AMSAT-EA/easat-2/control termal/IMG_7941.JPG

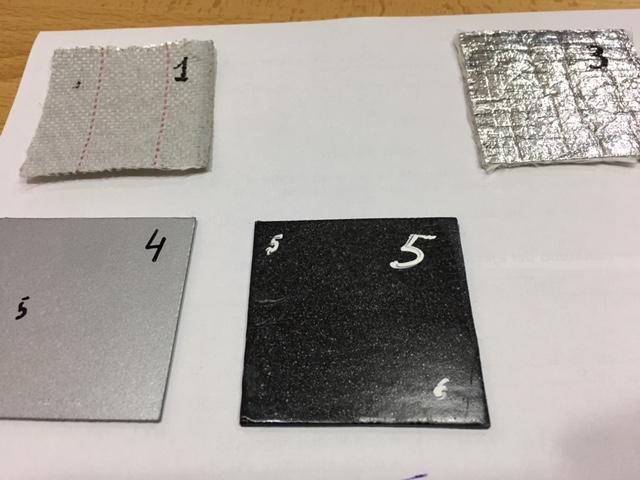
control termal/IMG_7941.JPG
