AMSAT-EA/easat-2/control termal/IMG_8060.JPG

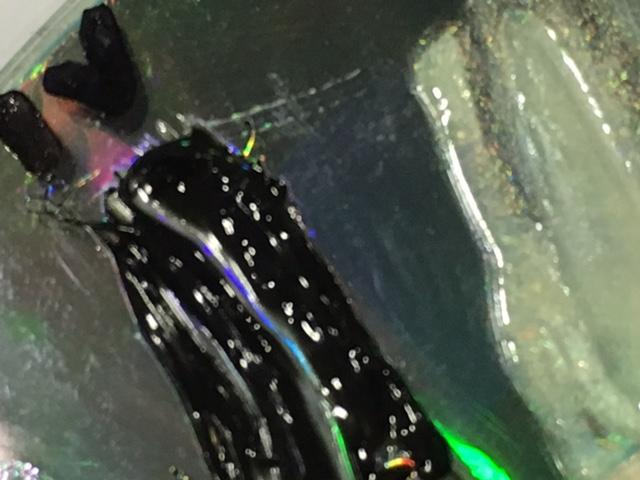
control termal/IMG_8060.JPG
