AMSAT-EA/easat-2/README.md

# easat-2
EASAT-2 satellite

This is the AMSAT EA Github repository for EASAT2 satellite project.

This is mainly an open hardware and software project and it is open to students.
The goal is designing and building a small FM repeater satellite, with CW beacon, in a pocketQube structure.

For more information visit our website at:

https://www.amsat-ea.org/easat2/

Este es el repositorio GitHub del proyecto de satélite EASAT2 de AMSAT EA.
Es un proyecto abierto de hardware y software.
El objetivo es diseñar y construir un pequeño satélite repetidor de FM, con una baliza morse, en una estructura del tipo pocketQube.

Para más información visita nuestra web en:

https://www.amsat-ea.org/easat2/
