AMSAT-EA/easat-2/control termal/Mat_1.pdf

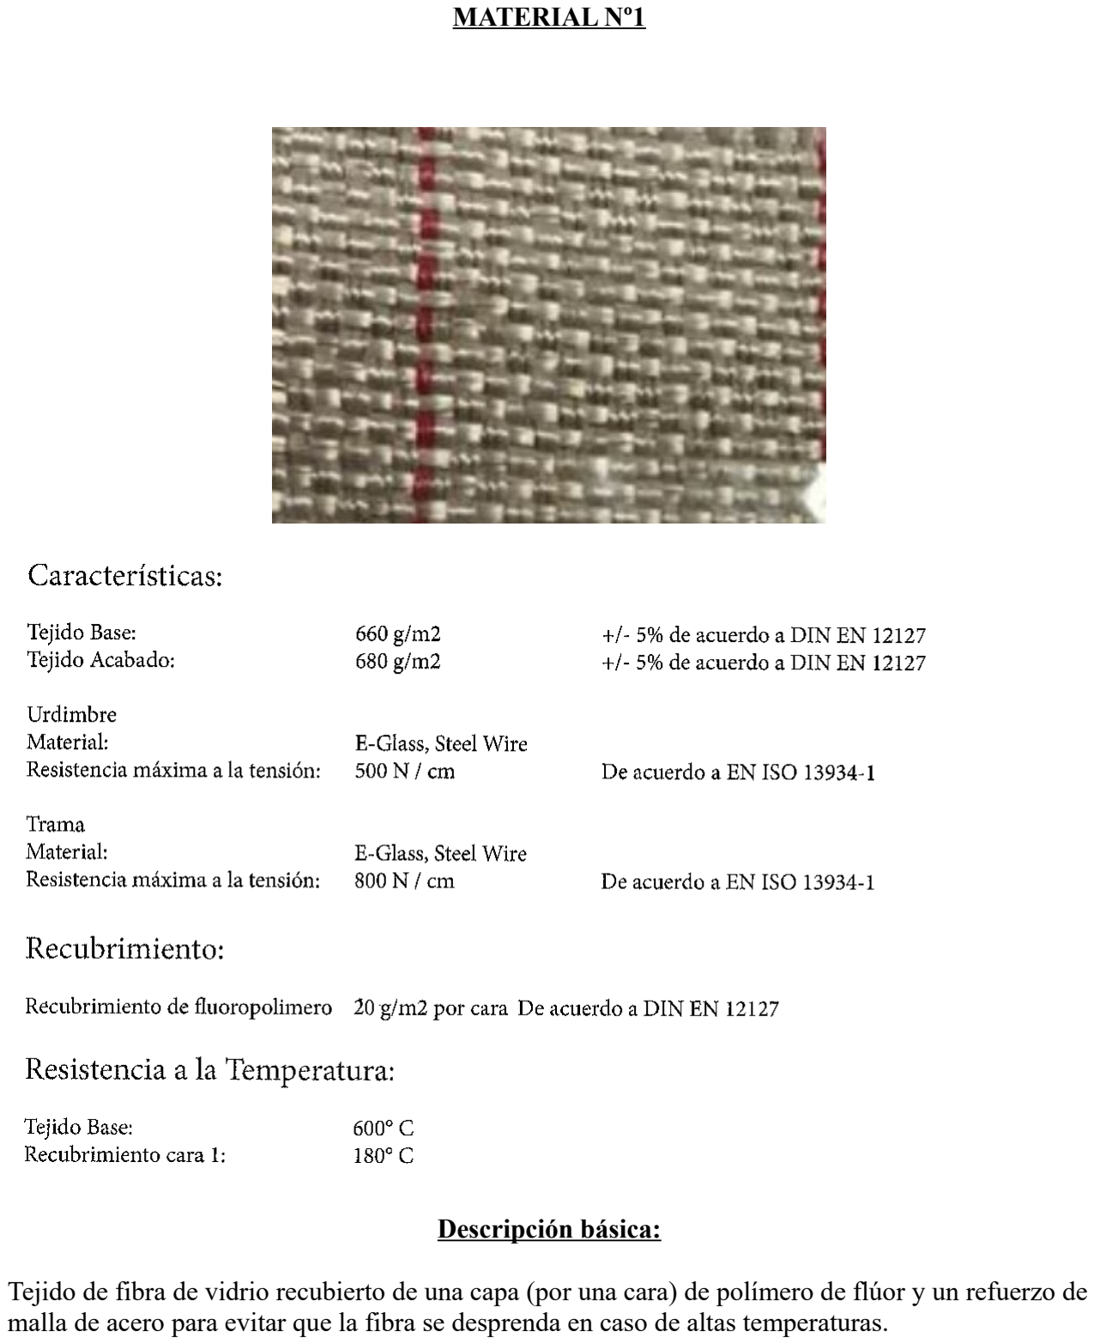
[picture p39: page 1]

MATERIAL Nº1

Descripción básica:

Tejido de fibra de vidrio recubierto de una capa (por una cara) de polímero de flúor y un refuerzo de malla de acero para evitar que la fibra se desprenda en caso de altas temperaturas.
