AMSAT-EA/easat-2/control termal/Mat_2.pdf

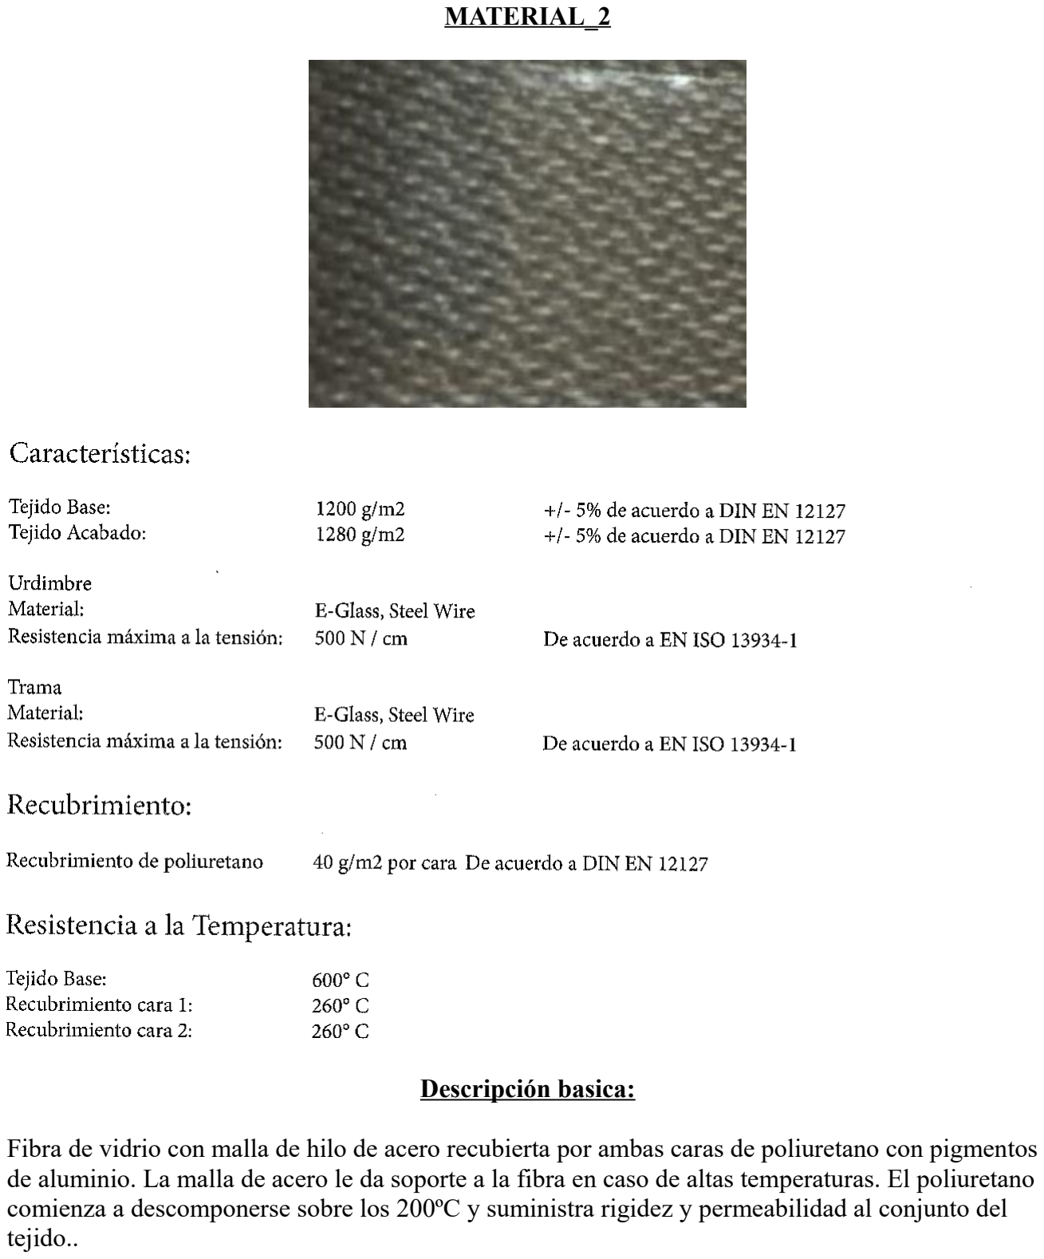
[picture p40: page 1]

MATERIAL_2

Descripción basica:

Fibra de vidrio con malla de hilo de acero recubierta por ambas caras de poliuretano con pigmentos de aluminio. La malla de acero le da soporte a la fibra en caso de altas temperaturas. El poliuretano comienza a descomponerse sobre los 200ºC y suministra rigidez y permeabilidad al conjunto del tejido..
