AMSAT-EA/easat-2/control termal/Mat_3.pdf

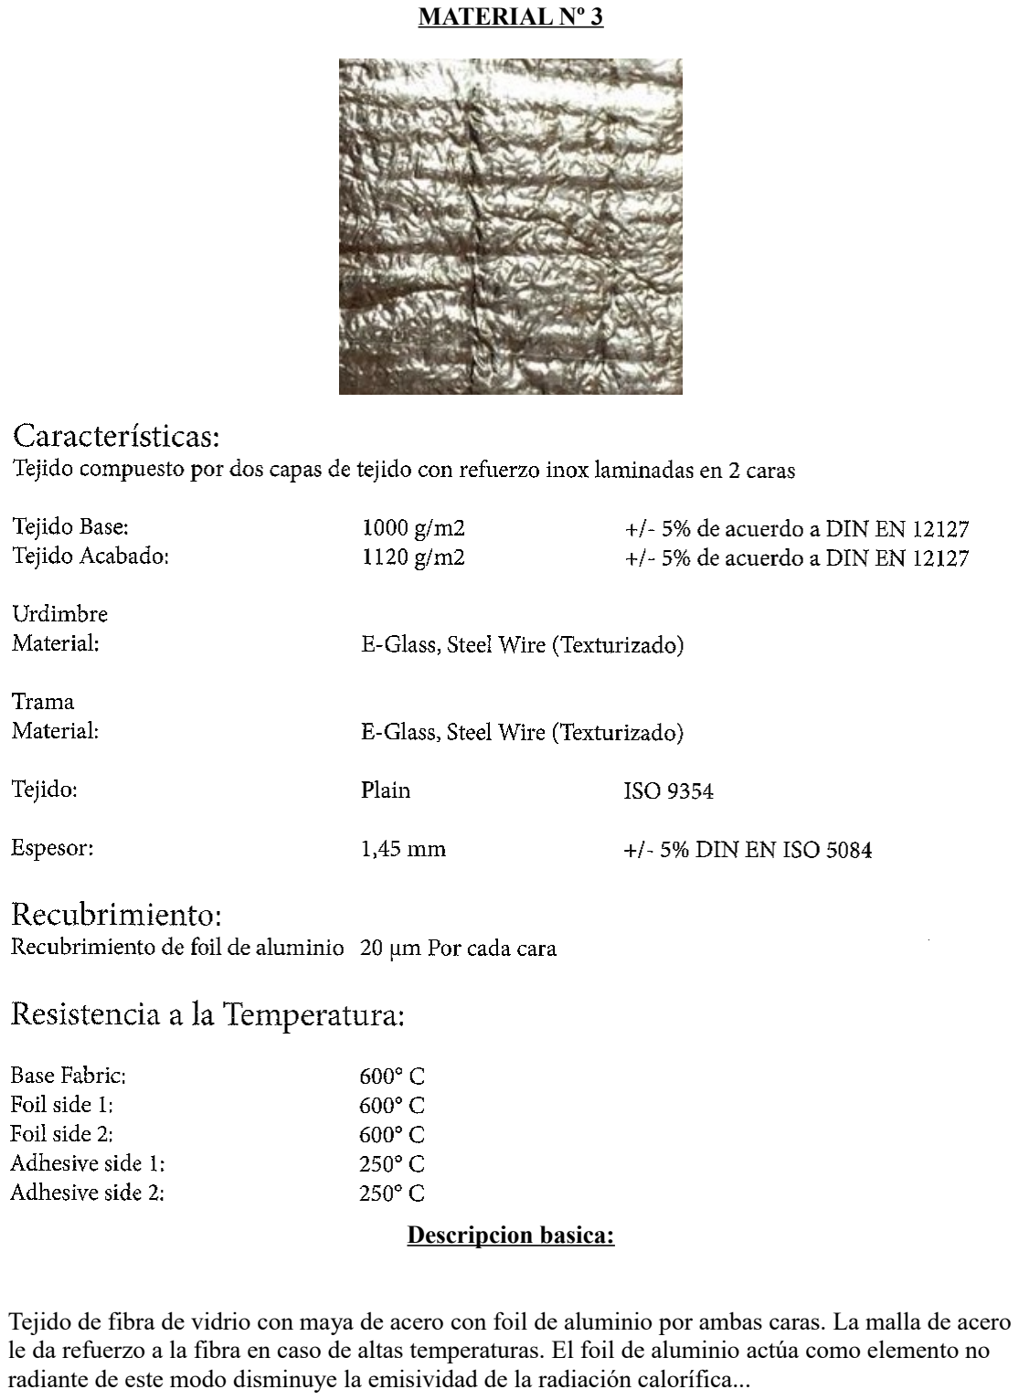
[picture p41: page 1]

MATERIAL Nº 3

Descripcion basica:

Tejido de fibra de vidrio con maya de acero con foil de aluminio por ambas caras. La malla de acero le da refuerzo a la fibra en caso de altas temperaturas. El foil de aluminio actúa como elemento no radiante de este modo disminuye la emisividad de la radiación calorífica...
