AMSAT-EA/easat-2/control termal/Ensayos_Mat_1.pdf

ENSAYOS TERMICOS PARA EASAT-2 CON MLI

Estimados compañeros como ya sabéis que viene siendo habitual en mi, adjunto os presento nuevos ensayos que he estado haciendo con los materiales MLI de que dispongo y que en anteriores entregas he ido exponiendo en la web del proyecto en la sección térmica..

En este caso he querido poner a prueba las mallas a llama directa para ver como se comporta la estructura y ver la capacidad del material una vez alcanzada una temperatura elevada.

Las pruebas esta vez están hechas en ambiente normal no como las anteriores que las hice en campana de vacío, lo cual lógicamente lleva a la transmisión de calor en condiciones de conducción cosa que no ocurre en el vacío. Pero creo que es interesante observar como se comportan estos materiales en condiciones adversas y como puede afectar a la estructura del sat...

El primer material numerado con el 1
es una MLI que esta expuesta en los archivos del proyecto y fundamentalmente es una urdimbre de hilo de acero sobre fibra de vidrio con una silicona resistente a la temperatura.

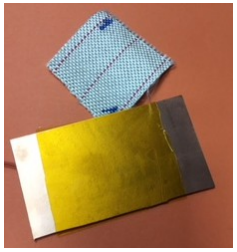
[picture p74: figure]

Fig.1 material nº1 y placa PCB con Kapton

El material lo he testeado sobre una placa de PCB de una cara en fibra de vidrio..

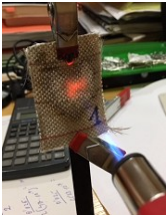
[picture p75: figure]
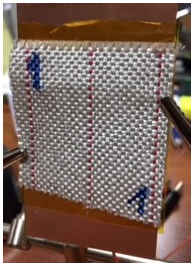
[picture p76: figure]

Fig.2 Foco de llama sobre Mat_1 | Fig.3 Colocación Mat_1 sobre soporte test

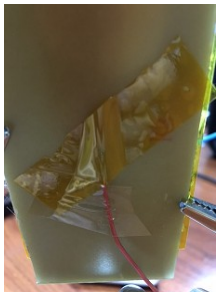
[picture p77: figure]

Fig. 4 Sonda termopar tras PCB

Al aplicar la llama al material tal y como se aprecia en las imágenes, puede verse como al cabo de unos segundos comienza a elevar su temperatura y acercarse poco a poco al rojo incandescente..

Las pruebas las he echo en 00:01:04 seg tal y como podéis ver en los datos reflejados al final.

La llama directa como podéis apreciar en los fotogramas térmicos ha alcanzado hasta 220 ºC y en la parte trasera del PCB donde tenia el termopar alcanzo según muestro en los datos y las gráficas 138,1 ºC..

Tras el tiempo de aplicación de la llama, (registre también durante unos cuantos segundos mas la curva de descenso de la temperatura, lo cual podéis ver en los datos..) se pueden apreciar los efectos que ha tenido sobre el material y la PCB....

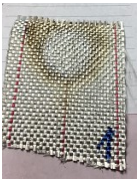
[picture p78: figure]
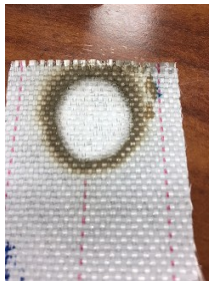
[picture p79: figure]
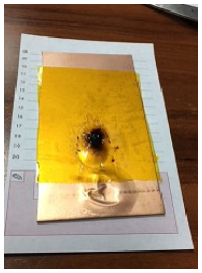
[picture p80: figure]

Fig. 5 cara frontal Mat_1 Fig. 6 cara trasera Mat_1 Fig. 7 cara frontal PCB tras el MLI

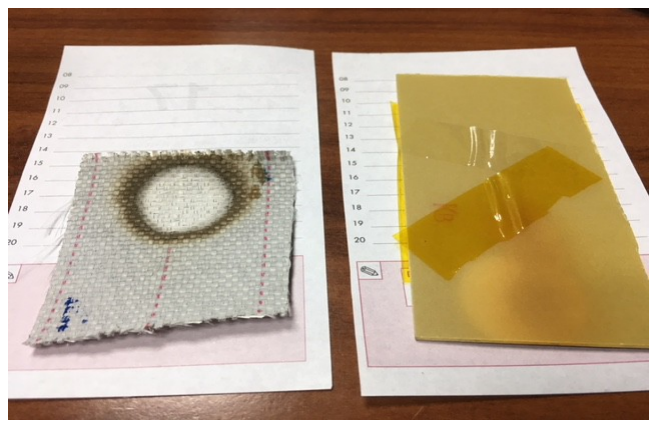
[picture p81: figure]

Fig.8 Mat_1 cara trasera y cara trasera PCB

Y este es el aspecto del material. Y en las siguientes fotos el material ampliado..

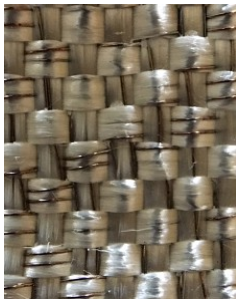
[picture p82: figure]
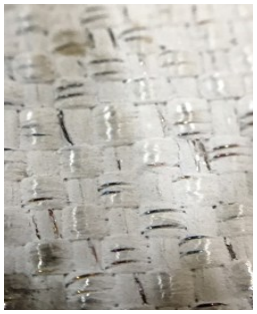
[picture p83: figure]

Fig. 9 Detalle urdimbre y fibra cara frontal Fig. 10 Detalle urdimbre y fibra cara posterior

Como podéis comprobar el material se comporta de un modo muy estable ante la temperatura elevada, y se dejan entrever la urdimbre de acero que le da resistencia y rigidez a la estructura.

El PCB por la cara en contacto con la MLI y el Kapton se ha llevado la peor parte y es una nota significativa la deformación de la capa de cobre debido seguramente al calentamiento del pegamento que se utiliza para adherir el cobre a la fibra, imagino que una vez en ebullición se ha evaporado y ha provocado la ampolla que se puede apreciar en la superficie un poco mas arriba del punto de calentamiento. Creo que este formato de estructura del Sat en PCB de 5x5 se ha descartado pero aun así he creído que este dato podía ser interesante.....

La parte trasera al contrario no presenta deformaciones en la fibra (un poco de decoloración) ni tampoco en la tira de Kapton que puse para sujetar el sensor.. “incluso un poco de film normal que puse para inmovilizar el cable del sensor tampoco de vio afectado.. “ :)

La termografia infrarroja nos sirve de referencia como indicador de la concentración y extensión del calor, en ambiente de conducción, radiación , etc.... En próximos ensayos realizare termografias en condiciones de vacío para ver la distribución de la temperatura sin el factor conducción....

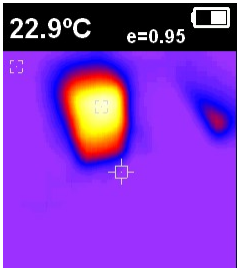
[picture p84: figure]
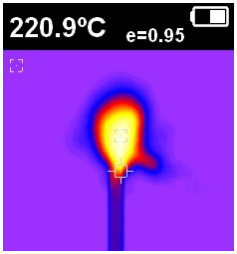
[picture p85: figure]

Fig: 11 Termografia infrarroja max tºC | Fig: 12 Termografia infrarroja en relajación

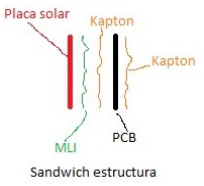
[picture p86: figure]

Fig. 14 Estructura propuesta

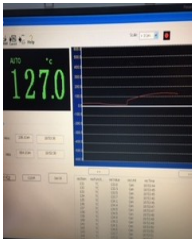
[picture p87: figure]

Fig. 13 Detalle max tºC en sonda

La idea inicial que expuse al principio de mis ensayos era la utilización de una especie de “sándwich” foto. 14 .
Si esto sirve de idea o ayuda para quien se encargue del aislamiento térmico del EASAT-2 creo que se podría realizar, bien enmarcando el conjunto con la estructura definitiva del sat o practicando unos agujeros en forma de ojales (estoy haciendo unas pruebas de cosido de urdimbre al rededor de la MLI y en los ojales) para que la MLI se pueda atornillar junto a las células solares...

Otro punto interesante de esta MLI es el ensayo de impacto que según he podido averiguar es de 30+/- 0,6 Kg con un empuje de hasta 180 J . Esto seria un punto también muy interesante ante fenómenos imprevistos de polvo o pequeñas partículas espaciales que pudieran impactar con el sat....

Próximamente subiré mas pruebas del resto de materiales para ver como se comportan.

TABLA DATOS DE SONDA:

recItem recFunction recValue recUnit recTime
1 | TC | 064.1 | Cen | 18:52:30
2 | TC | 065.5 | Cen | 18:52:30
3 | TC | 066.9 | Cen | 18:52:31
4 | TC | 067.6 | Cen | 18:52:31
5 | TC | 069.1 | Cen | 18:52:32
6 | TC | 070.5 | Cen | 18:52:33
7 | TC | 071.7 | Cen | 18:52:33
8 | TC | 072.4 | Cen | 18:52:34
9 | TC | 073.6 | Cen | 18:52:34
10 | TC | 074.8 | Cen | 18:52:35
11 | TC | 075.9 | Cen | 18:52:35
12 | TC | 076.5 | Cen | 18:52:36
13 | TC | 077.6 | Cen | 18:52:37
14 | TC | 078.7 | Cen | 18:52:37
15 | TC | 079.9 | Cen | 18:52:38
16 | TC | 080.5 | Cen | 18:52:38
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
151 | TC | 130.8 | Cen | 18:53:55
152 | TC | 130.2 | Cen | 18:53:55

153 | TC | 129.6 | Cen | 18:53:56
154 | TC | 129.0 | Cen | 18:53:57
155 | TC | 128.6 | Cen | 18:53:57
156 | TC | 128.0 | Cen | 18:53:58
157 | TC | 127.3 | Cen | 18:53:58
158 | TC | 127.0 | Cen | 18:53:59
