AMSAT-EA/easat-2/presentaciones/AMSAT EA - IBERRADIO 2017 SATELITE-EASAT2-rev4.pdf

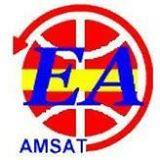
[picture p101: figure]

# SATÉLITE EASAT2

### Progreso y estado actual

# Equipo

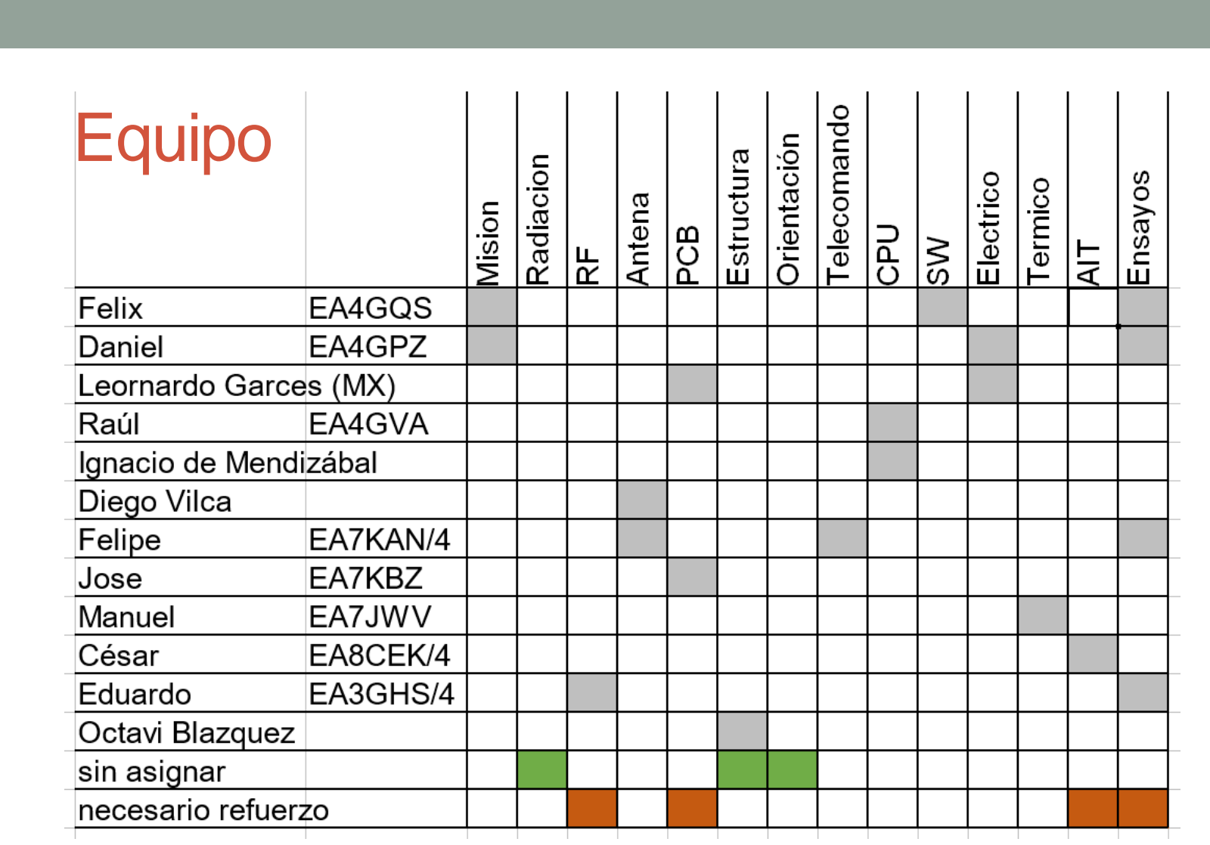
[picture p102: page 2]

# Misión

### - Satélite órbita baja para comunicaciones por voz - Modo principal de trabajo FM

- Pero posibilidad de otras modalidades (transpondedor lineal)

### - Subida en VHF y bajada en UHF - Operable con

- Walkie-talkies
- Antena directiva de mano

### - Arquitectura: PocketQube 5x5x10cm

# Organización

### - ¿Cuál es la lista de tareas a realizar para construir y lanzar un satélite al espacio? - Para ser exhaustivos y no olvidar nada, el plan se ha inspirado en los libros:

- Space mission engineering, The New SMAD, Larson-Wertz-Everett
- Spacecraft System Engineering Misión, Fortescue

# Tareas

### ÓRBITA Y TRANSPORTE

- Geometría orbital
- Deorbit
- Transporte
- Expulsor

### ENTORNO ESPACIAL

- Radiación
- Electroestática
- Selección Componentes

### CARGA UTIL

- Transponder VHF>UHF
- Antenas

### SUBSISTEMAS

- Estructura
- Orientación y control
- Telecomando/telemetría
- Unidad de control+Software
- Subsistema eléctrico EPS
- Control térmico

### AIT

- Modelos
- Fabricación+Ensamblaje
- Campaña de Ensayos

# Requisitos

### - Construir satélite para comunicaciones por voz - Modo principal: FM

- deseable otros modos (-> transpondedor lineal)

### - Subida en VHF y bajada en UHF - Operable con walkie-talkies y antena directiva de mano - Limitaciones

- Técnicas: algunos elementos deben adquirirse
- Estructura
- Paneles solares
- Económicas: mínimo coste posible
- PocketQube 5x5x10cm preferible a CubeSat
- Órbita LEO
- Componentes no específicos espacio/balance coste-riesgo

# Orbita, Transporte y Lanzador (POD)

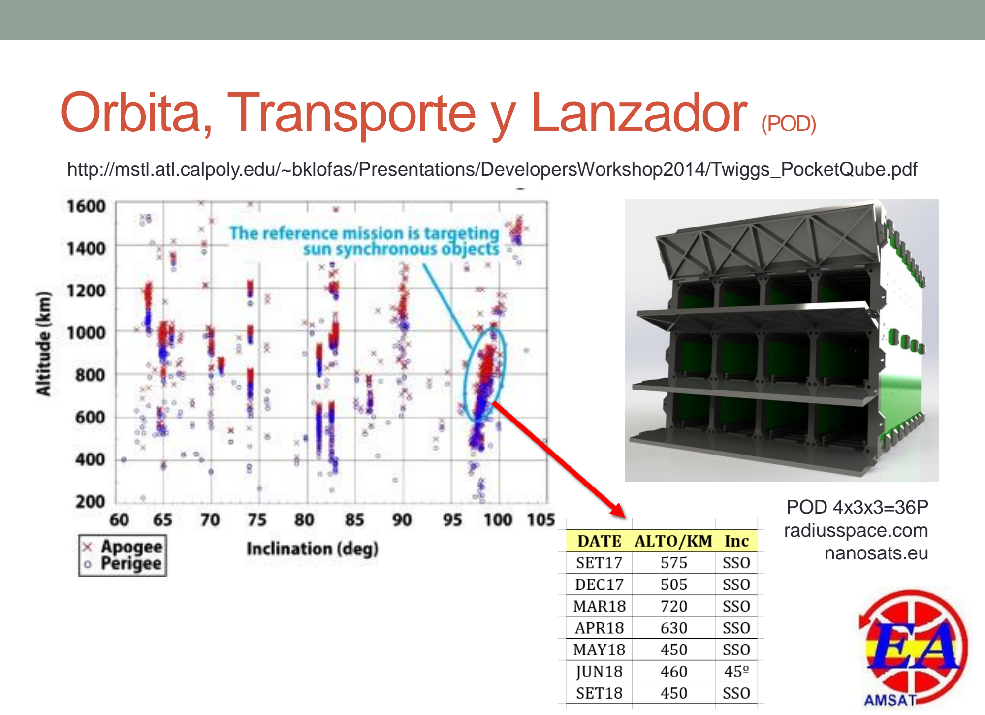
[picture p103: page 7]

http://mstl.atl.calpoly.edu/~bklofas/Presentations/DevelopersWorkshop2014/Twiggs_PocketQube.pdf

POD 4x3x3=36P
radiusspace.com
nanosats.eu

# Entorno Espacial

- Radiación
- Electroestática
- Selección Componentes

SIN ASIGNAR, SE BUSCA VOLUNTARIO

# Determinación de orientación y control

Eje Z:
- Un imán alinea el eje con el campo magnético de la tierra
- Sobre este eje se monta un dipolo RX/TX
Ejes X/Y:
- Giran libremente
- Estimado: 10grados/min
IDEAS:
- Uso de pinturas (?)
- Uso de los paneles solares para conocer la posición del sol (?)
- ….

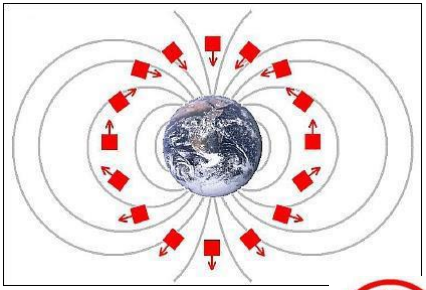
[picture p104: figure]

SIN ASIGNAR, SE BUSCA VOLUNTARIO

# Energía generada

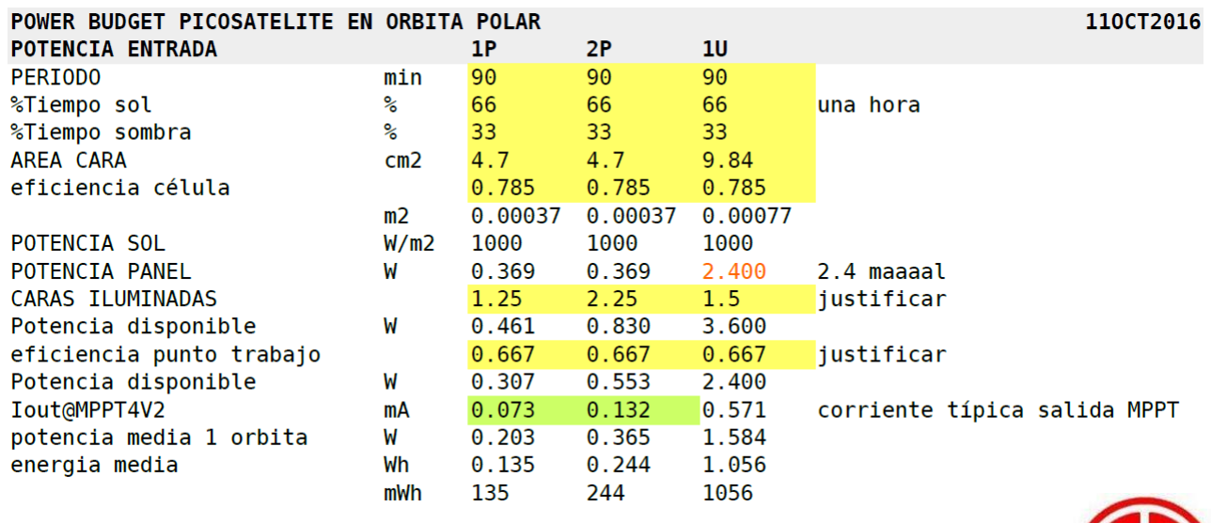
[picture p105: figure]

# Balance de Enlace

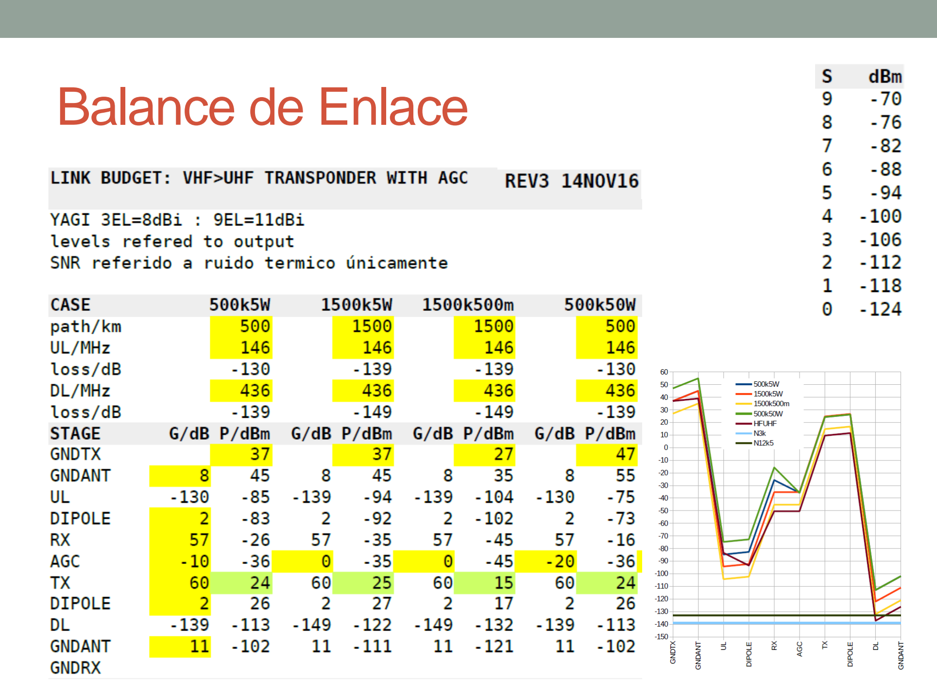
[picture p106: page 11]

# Partes del satélite

- Transponder VHF>UHF
- Antenas
- Estructura
- Orientación y control
- Telecomando/telemetría
- Unidad de control
- Software
- Subsistema eléctrico EPS
- Control térmico

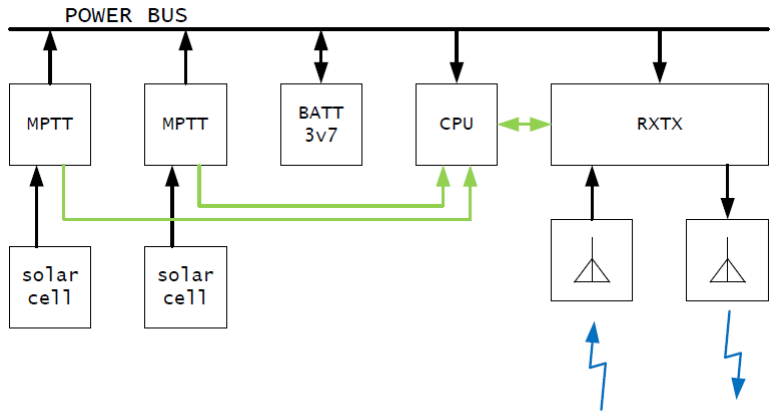
[picture p107: figure]
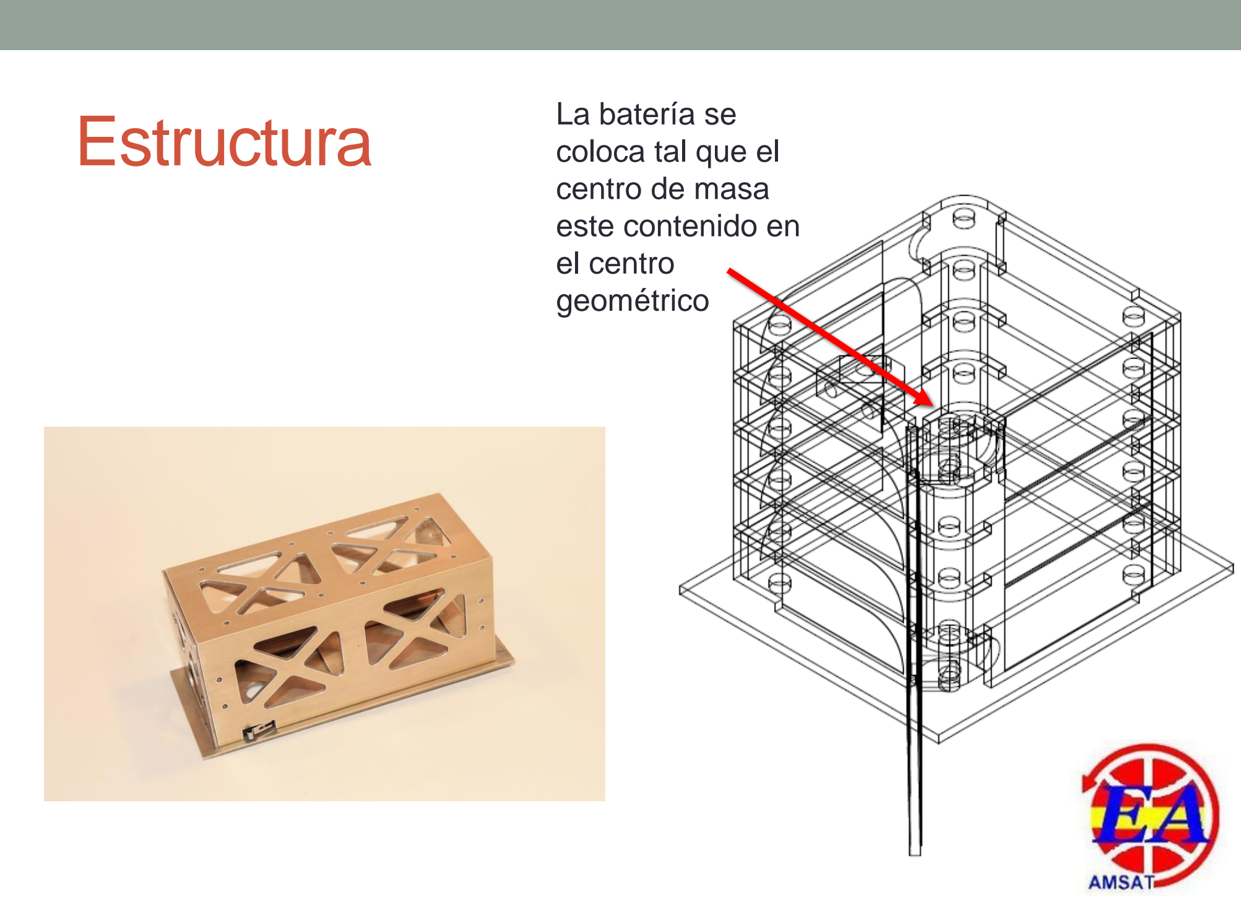
[picture p108: page 13]

Estructura | La batería se coloca tal que el centro de masa este contenido en el centro geométrico

# Unidad de Control CPU

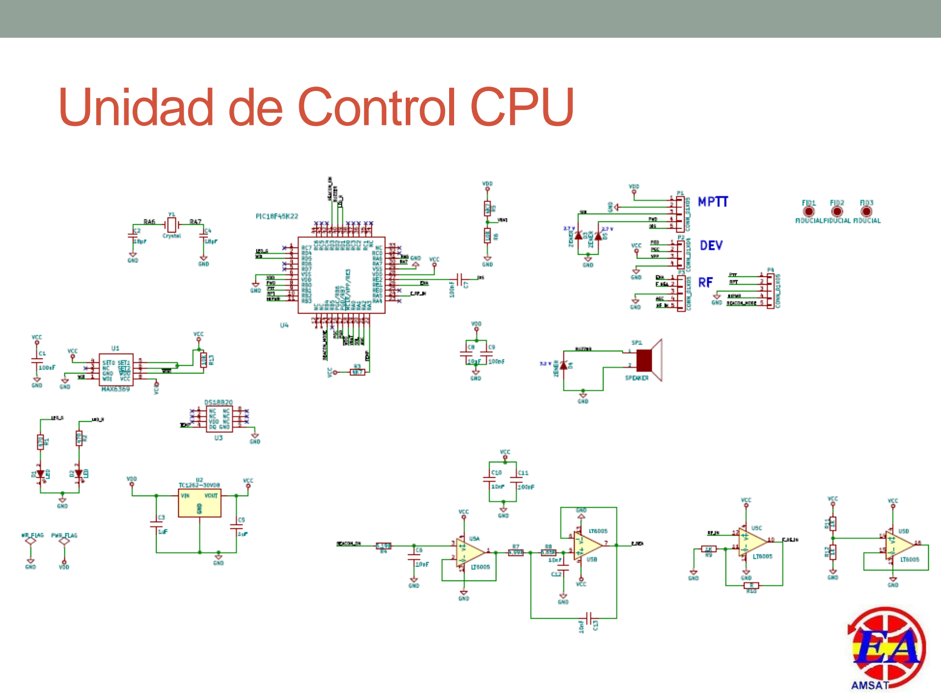
[picture p109: page 14]

# Unidad de Control CPU (dev)

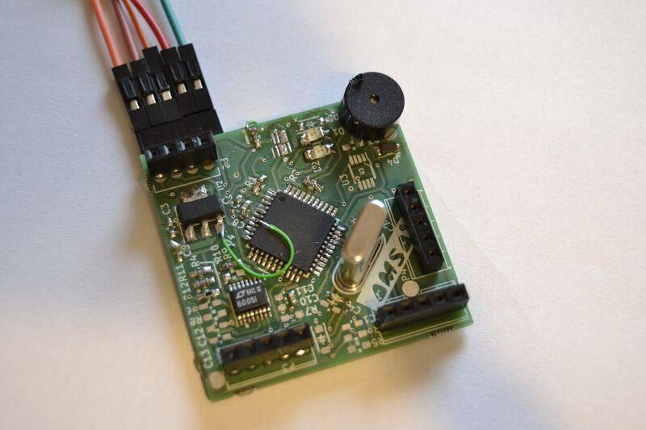
[picture p110: figure]

# Subsistema eléctrico

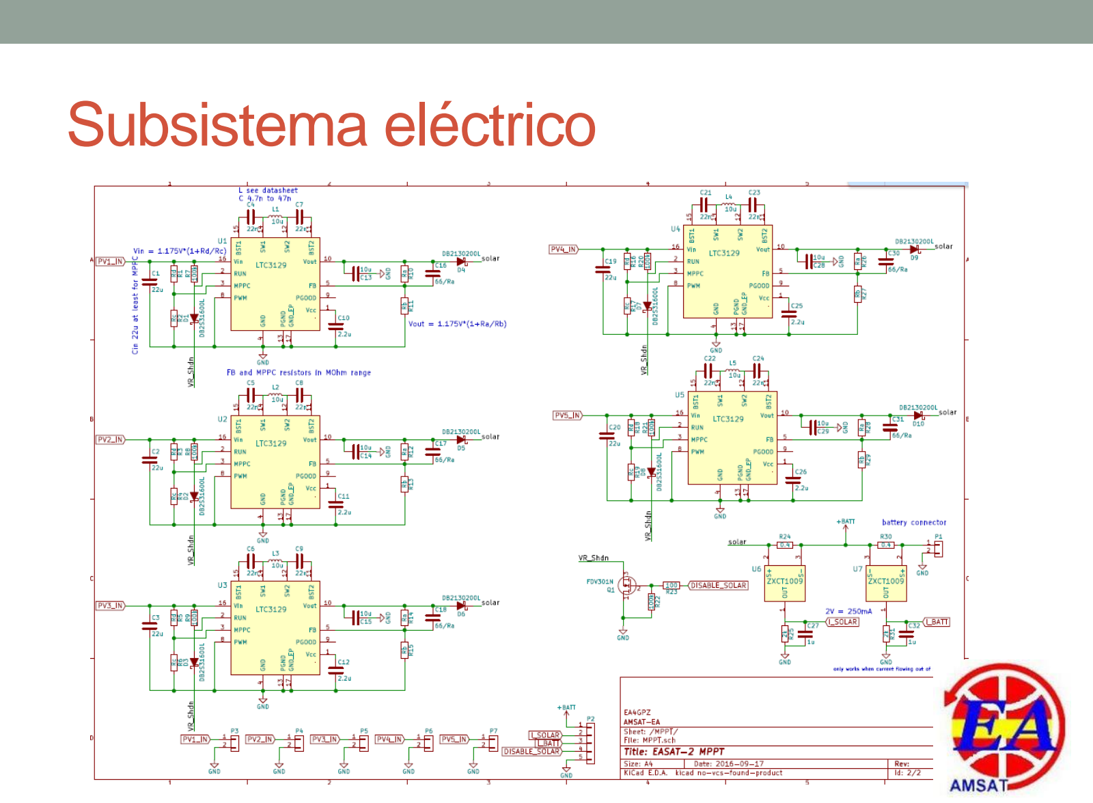
[picture p111: page 16]

# Transponder VHF>UHF

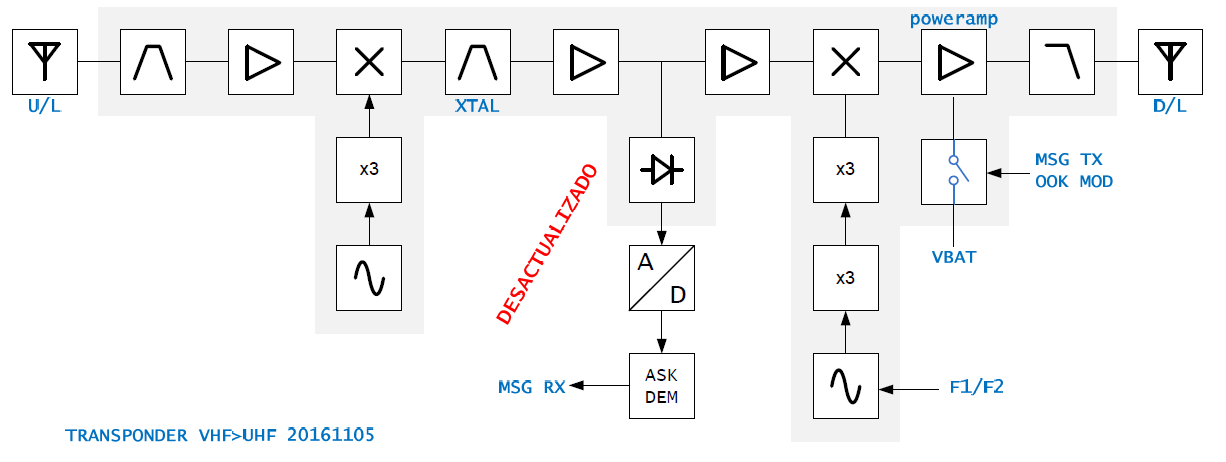
[picture p112: figure]

# Control térmico

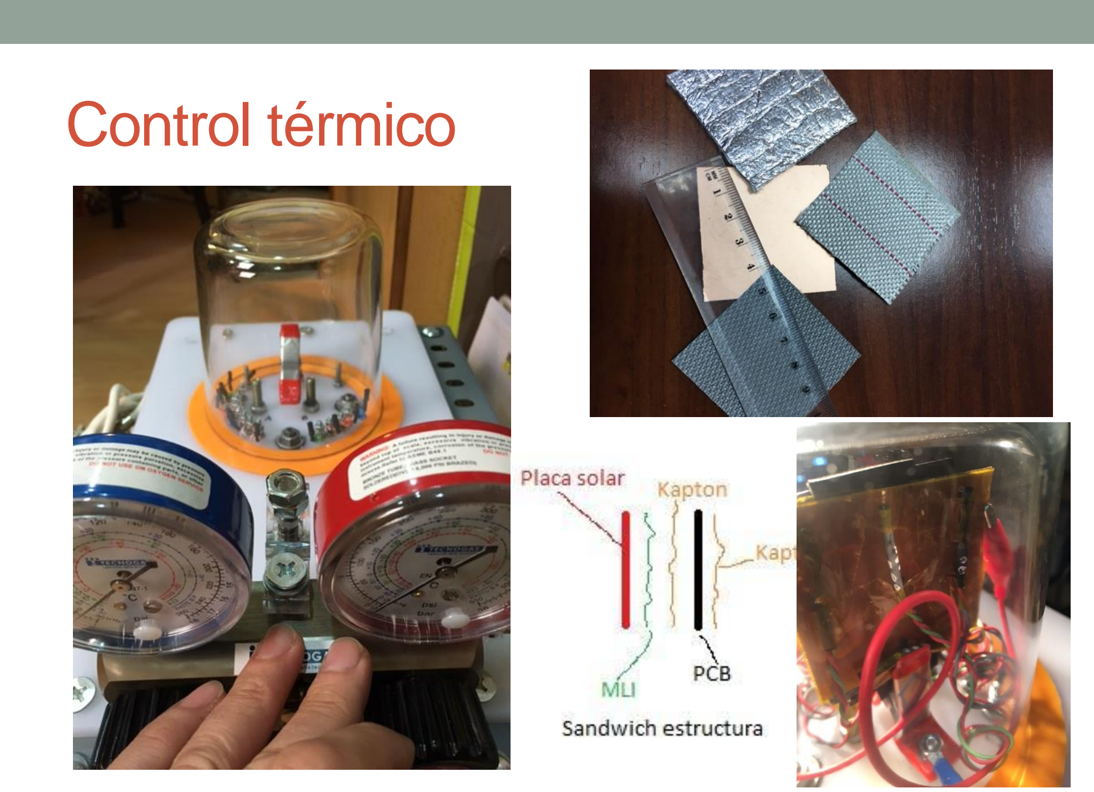
[picture p113: page 18]

# Filosofía de modelos

- Prototipo
- funcional (con placas RF comerciales)
- eléctrico BB (equivalente exacto eléctrico)
- Modelo
- de Vuelo FM
- de Calificación QM
- FM y QM idénticos
- El modelo FM
- se ensaya en un rango reducido de temperaturas y vibraciones para evitar estresarlo
- es el que finalmente vuela
- El modelo QM
- Se estresa durante los ensayos
- se queda en tierra y sirve como banco de ensayos a efectos comparativos
- vuela en la siguiente oportunidad, si el cohete explota

# ¿Te unes al reto?

contacto@amsat-ea.org

Sigue el desarrollo en:

https://www.amsat-ea.org/easat2https://github.com/AMSAT-EA/easat-2

# ¿Comentarios? ¿Preguntas?
