AMSAT-EA/easat-2/control termal/Foto_1.jpg

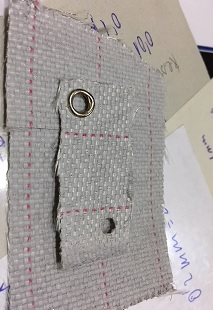
control termal/Foto_1.jpg
