AMSAT-EA/easat-2/control termal/Foto_2.jpg

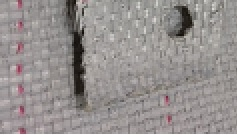
control termal/Foto_2.jpg
