AMSAT-EA/easat-2/control termal/image1 (1).JPG

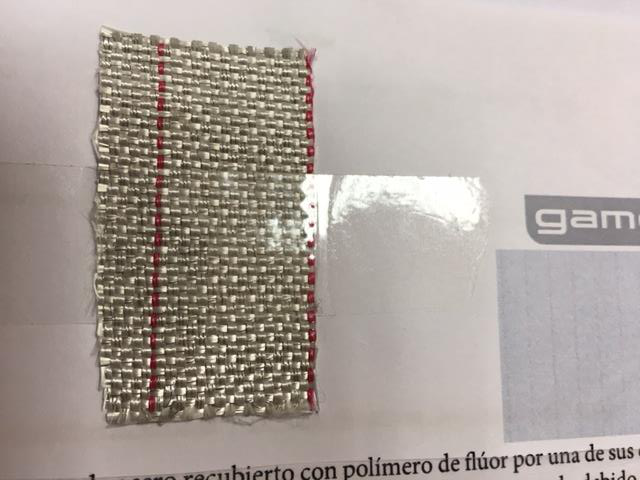
control termal/image1 (1).JPG
