AMSAT-EA/easat-2/control termal/image2.JPG

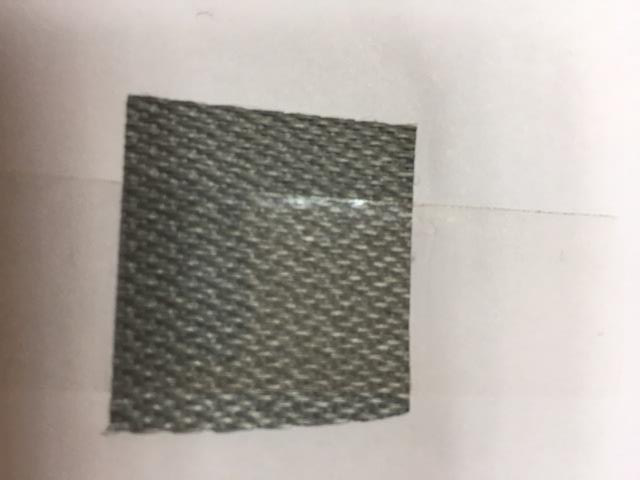
control termal/image2.JPG
