AMSAT-EA/easat-2/control termal/image3.JPG

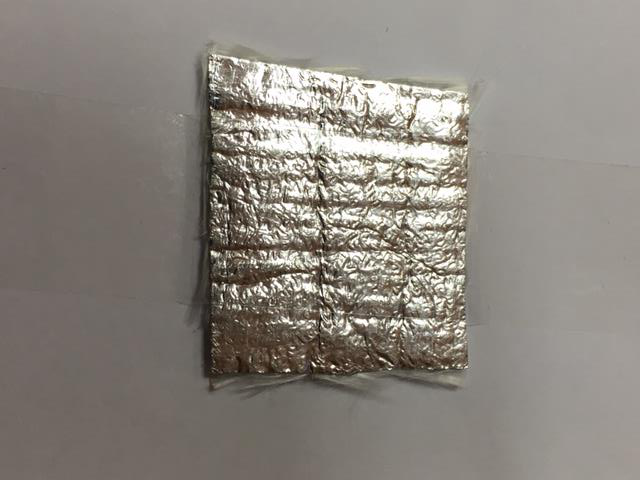
control termal/image3.JPG
