AMSAT-EA/easat-2/control termal/IMG_6163.JPG

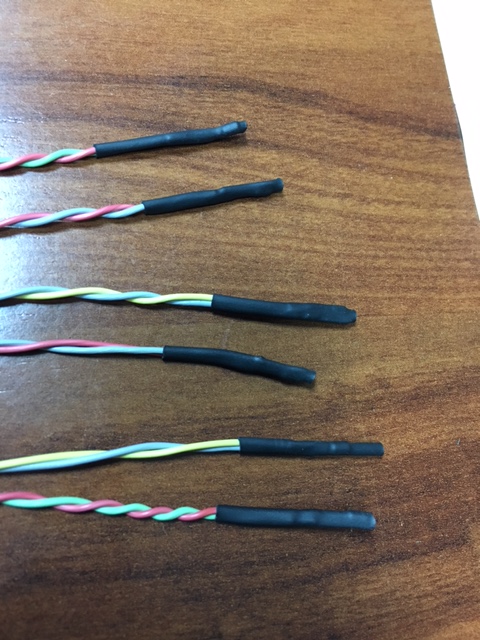
control termal/IMG_6163.JPG
