AMSAT-EA/easat-2/control termal/IMG_6236.JPG

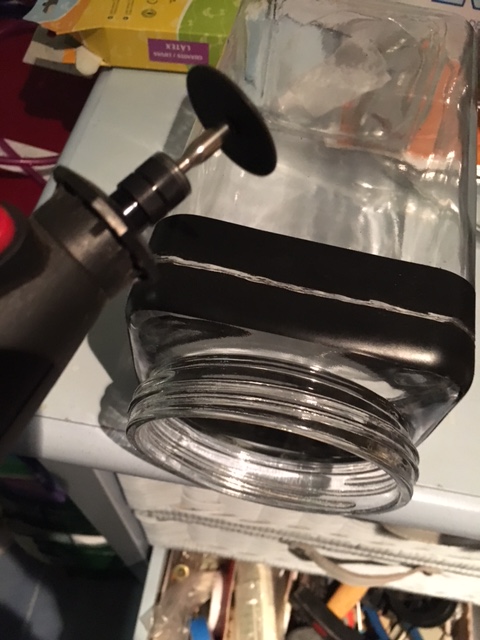
control termal/IMG_6236.JPG
