AMSAT-EA/easat-2/control termal/IMG_6239.JPG

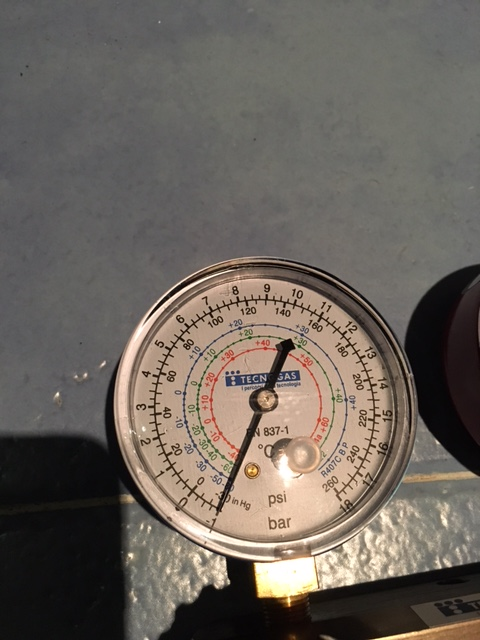
control termal/IMG_6239.JPG
