AMSAT-EA/easat-2/control termal/IMG_6240.JPG

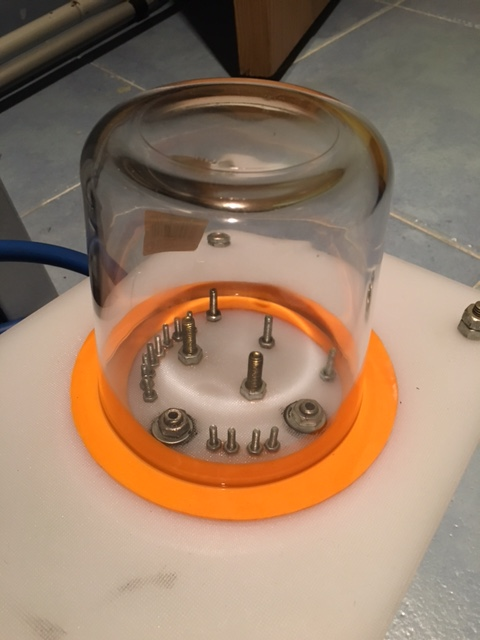
control termal/IMG_6240.JPG
