AMSAT-EA/easat-2/control termal/IMG_7440.JPG

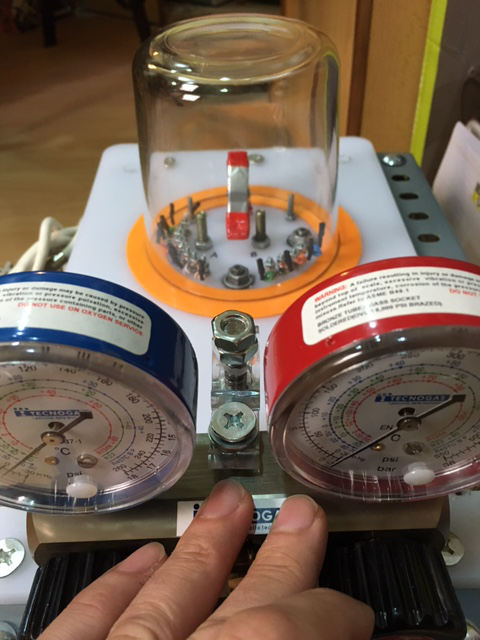
control termal/IMG_7440.JPG
