AMSAT-EA/easat-2/control termal/IMG_7460.JPG

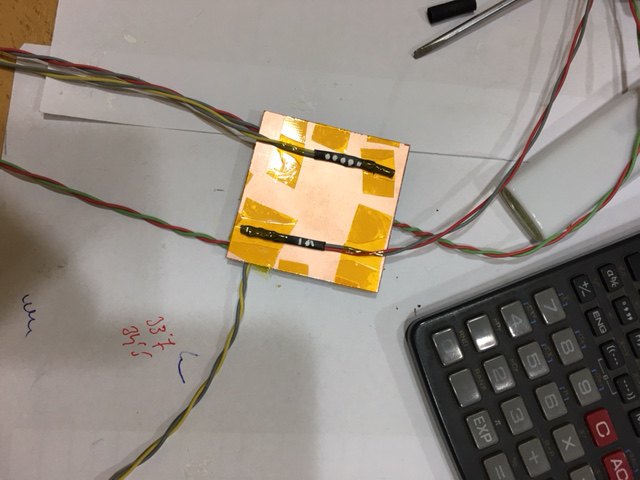
control termal/IMG_7460.JPG
