AMSAT-EA/easat-2/control termal/IMG_7461.JPG

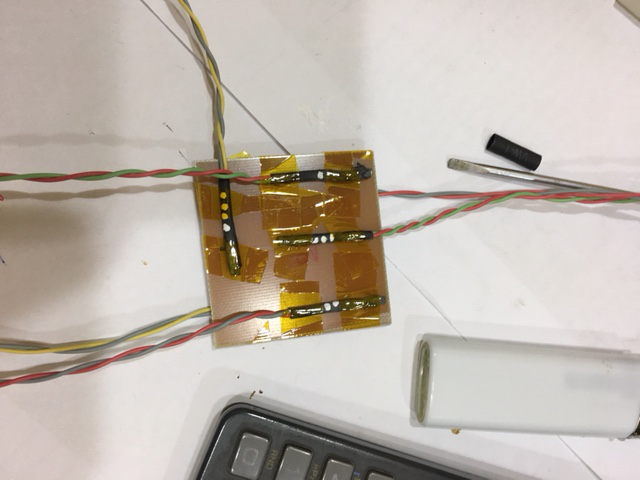
control termal/IMG_7461.JPG
