AMSAT-EA/easat-2/control termal/IMG_7466.JPG

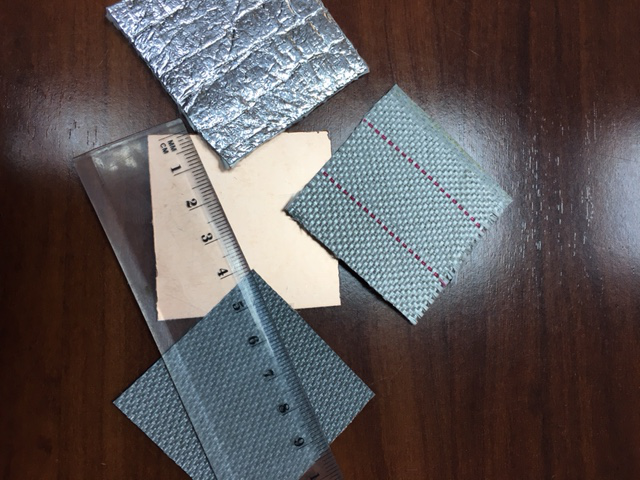
control termal/IMG_7466.JPG
