AMSAT-EA/easat-2/control termal/IMG_7469.JPG

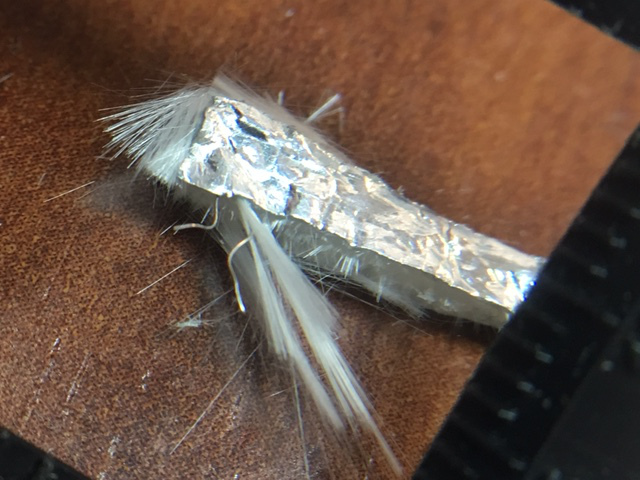
control termal/IMG_7469.JPG
