AMSAT-EA/easat-2/control termal/IMG_7470.JPG

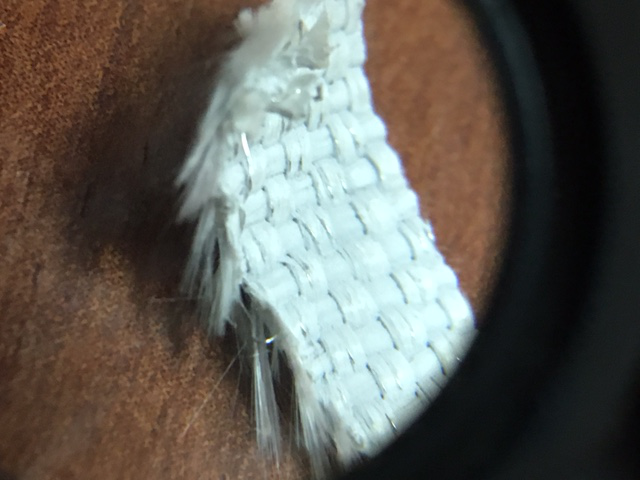
control termal/IMG_7470.JPG
