AMSAT-EA/easat-2/control termal/IMG_7478.JPG

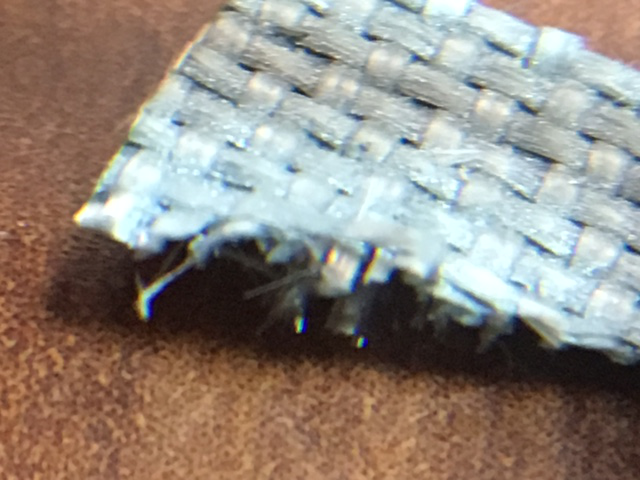
control termal/IMG_7478.JPG
