AMSAT-EA/easat-2/control termal/IMG_7540.JPG

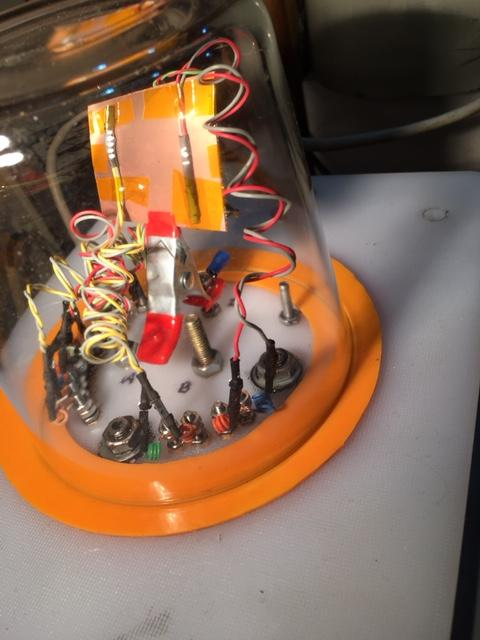
control termal/IMG_7540.JPG
