AMSAT-EA/easat-2/control termal/IMG_7542.JPG

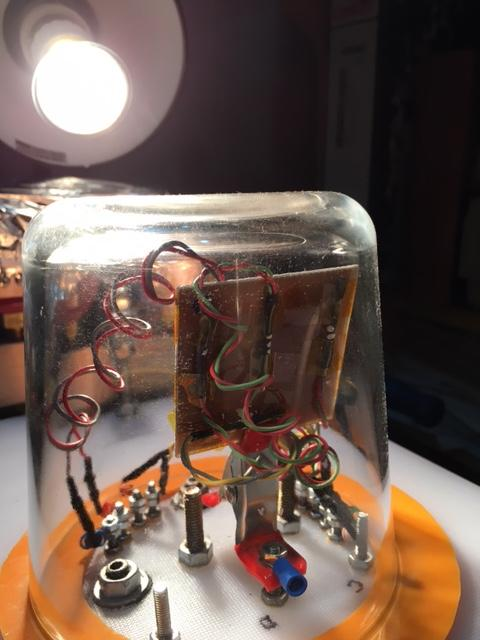
control termal/IMG_7542.JPG
