AMSAT-EA/easat-2/control termal/IMG_7548.JPG

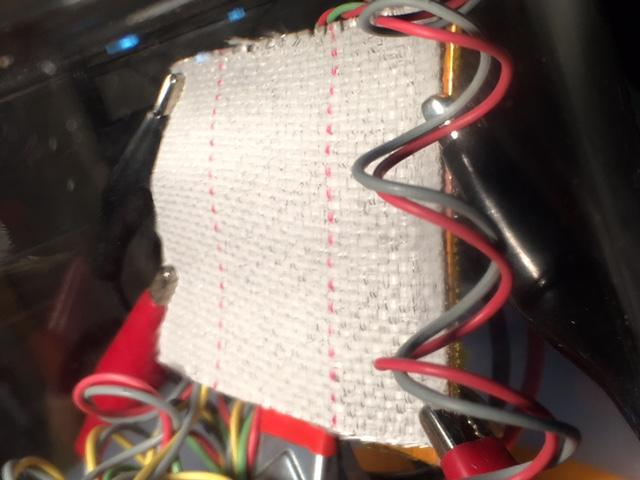
control termal/IMG_7548.JPG
