AMSAT-EA/easat-2/control termal/IMG_7549.JPG

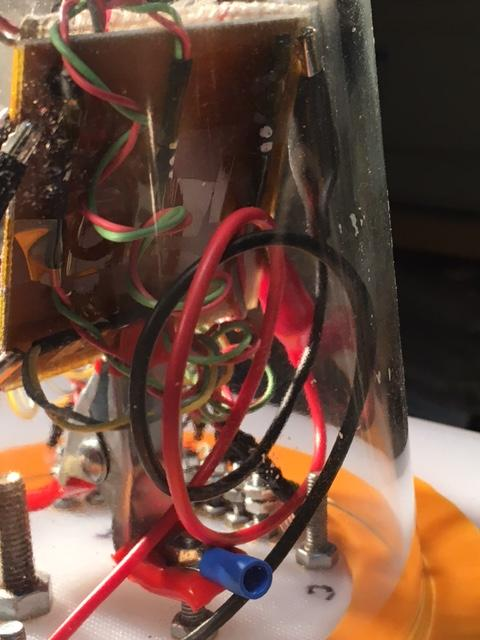
control termal/IMG_7549.JPG
