AMSAT-EA/easat-2/control termal/IMG_7943.JPG

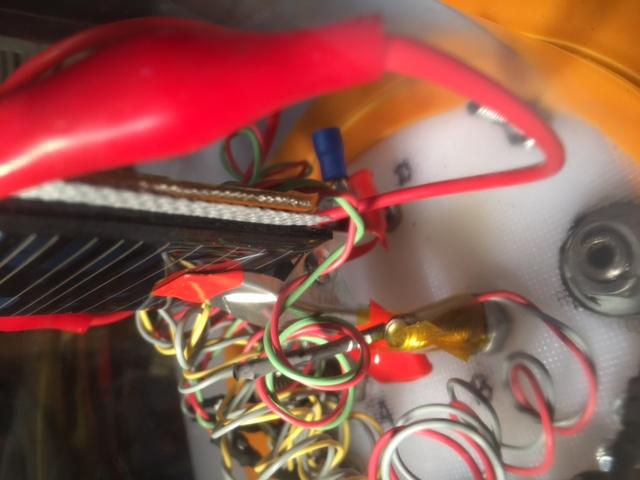
control termal/IMG_7943.JPG
