AMSAT-EA/easat-2/control termal/IMG_7944.JPG

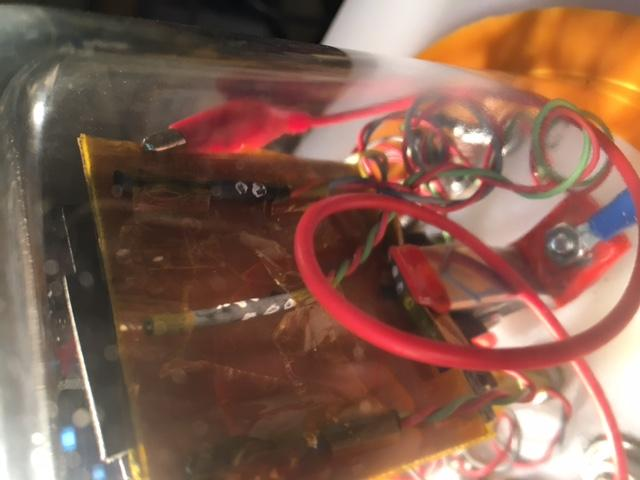
control termal/IMG_7944.JPG
