AMSAT-EA/easat-2/control termal/IMG_8010.JPG

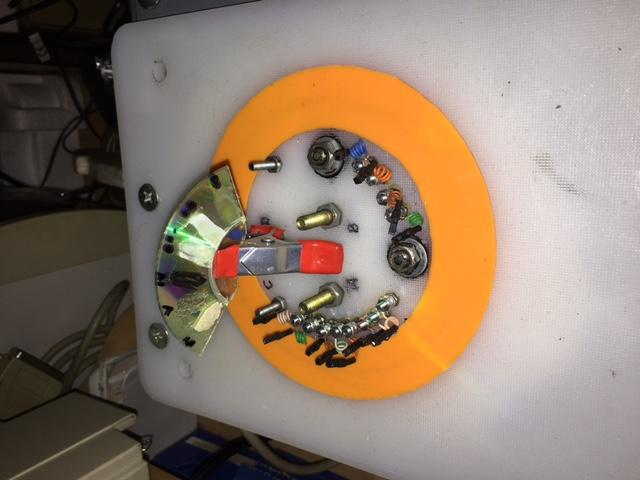
control termal/IMG_8010.JPG
