AMSAT-EA/easat-2/control termal/IMG_8011.JPG

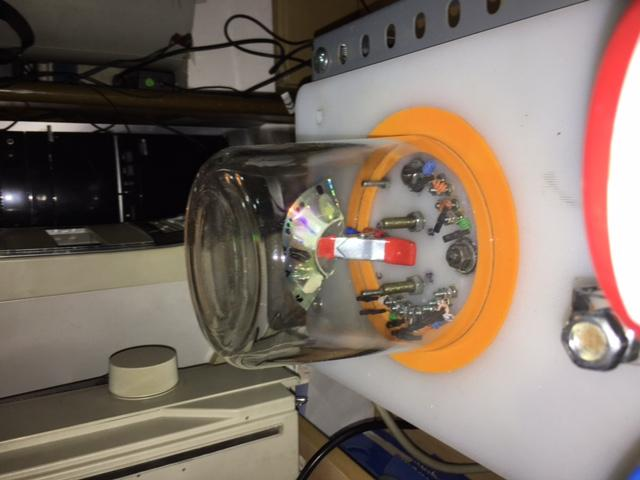
control termal/IMG_8011.JPG
