AMSAT-EA/easat-2/control termal/Sandwich_estructura.jpg

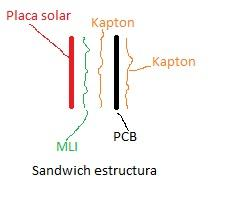
control termal/Sandwich_estructura.jpg
