AMSAT-EA/easat-2/control termal/Sat_1.jpg

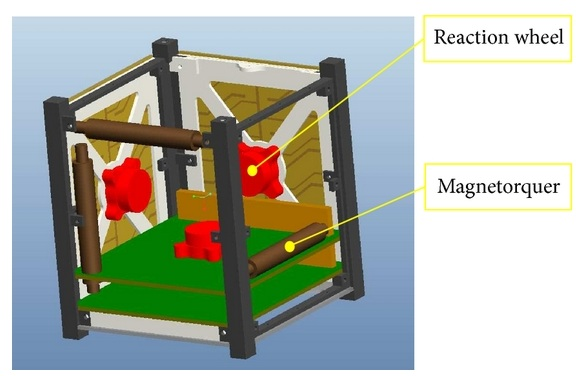
control termal/Sat_1.jpg
