AMSAT-EA/easat-2/control termal/Sat_2.jpg

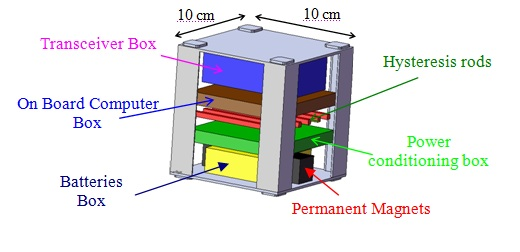
control termal/Sat_2.jpg
