AMSAT-EA/easat-2/control termal/Sat_3.jpg

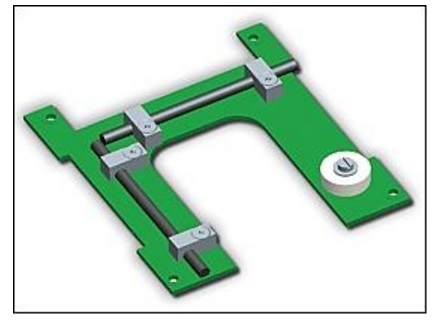
control termal/Sat_3.jpg
