AMSAT-EA/easat-2/control termal/Sol_Mat4_Vacio.jpg

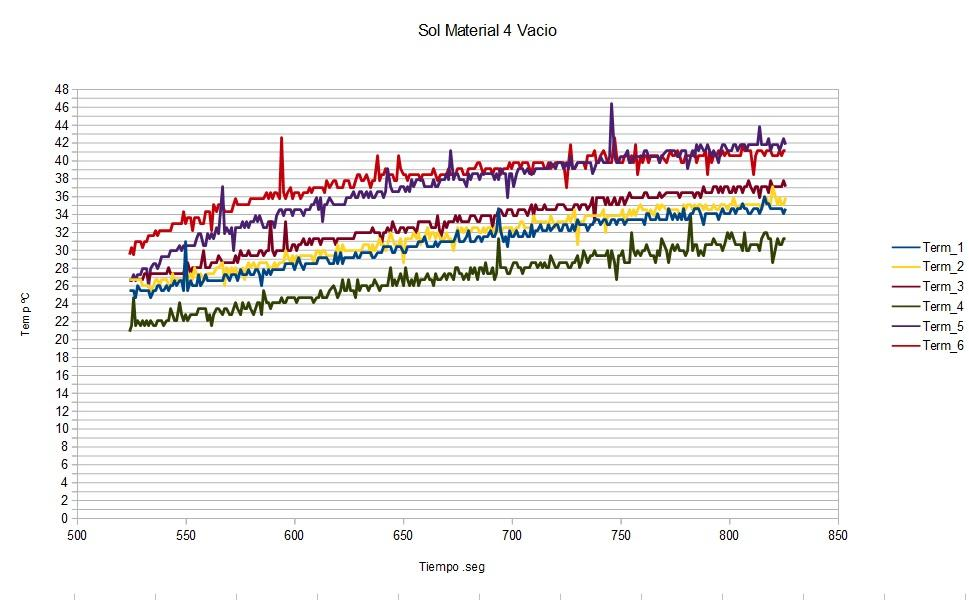
control termal/Sol_Mat4_Vacio.jpg
