AMSAT-EA/easat-2/control termal/Sol_Proteccion_Mat_1.jpg

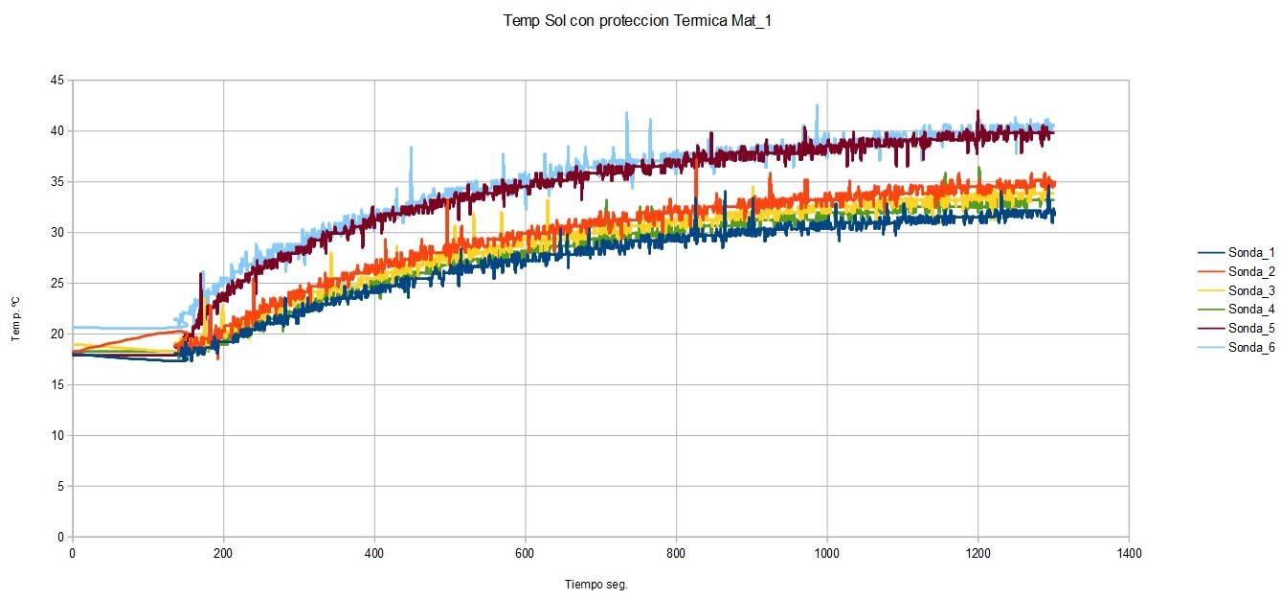
control termal/Sol_Proteccion_Mat_1.jpg
