AMSAT-EA/easat-2/control termal/Sol_Proteccion_Mat_2.jpg

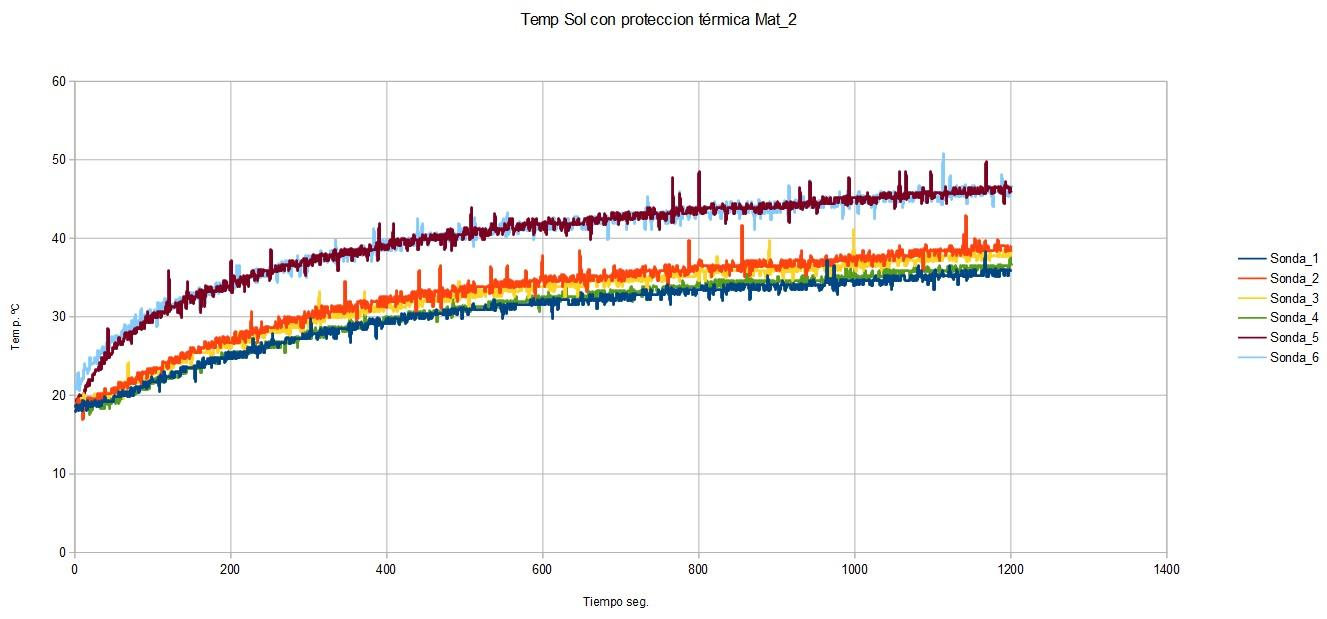
control termal/Sol_Proteccion_Mat_2.jpg
