AMSAT-EA/easat-2/control termal/Sol_Sandwich_Mat2_Vacio.jpg

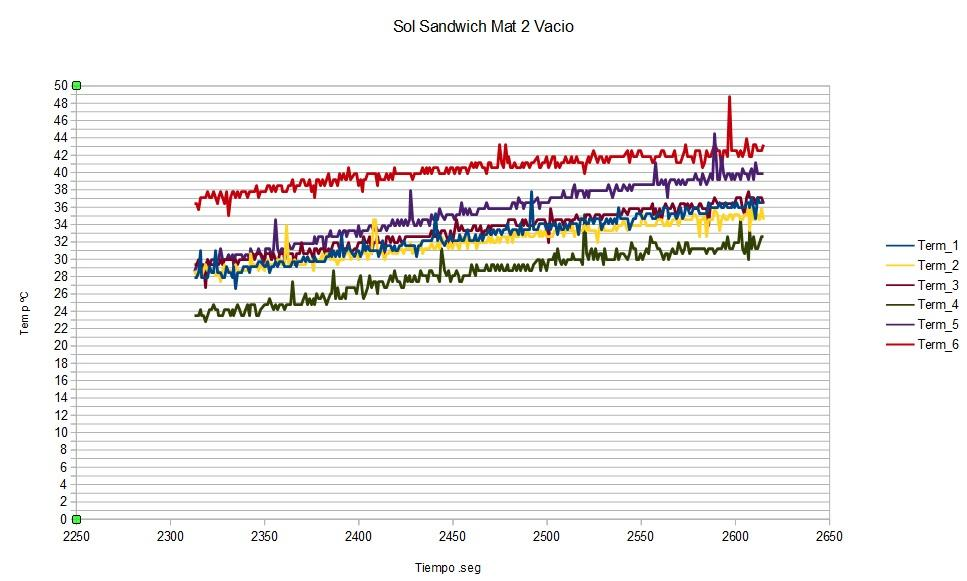
control termal/Sol_Sandwich_Mat2_Vacio.jpg
