AMSAT-EA/easat-2/control termal/Tabla_Temp.jpg

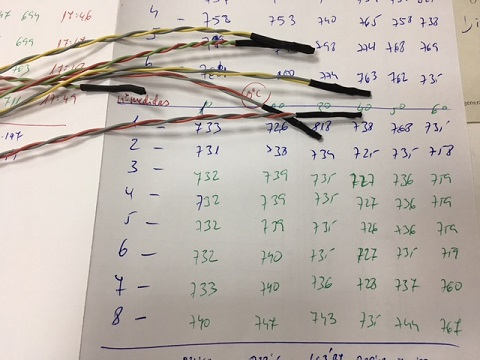
control termal/Tabla_Temp.jpg
