AMSAT-EA/easat-2/control termal/Temp_1.jpg

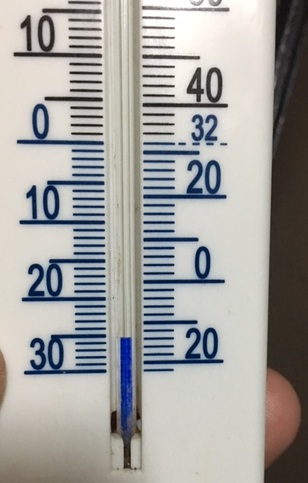
control termal/Temp_1.jpg
