AMSAT-EA/easat-2/control termal/Temp_Ambiente.jpg

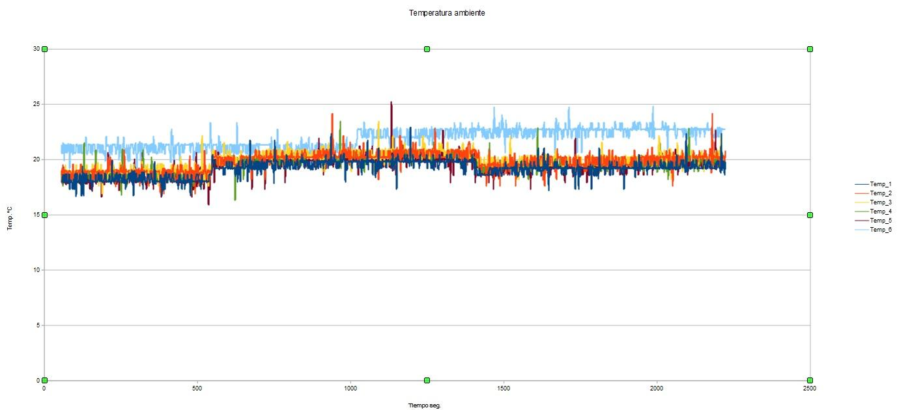
control termal/Temp_Ambiente.jpg
