AMSAT-EA/easat-2/control termal/Termo_1.jpg

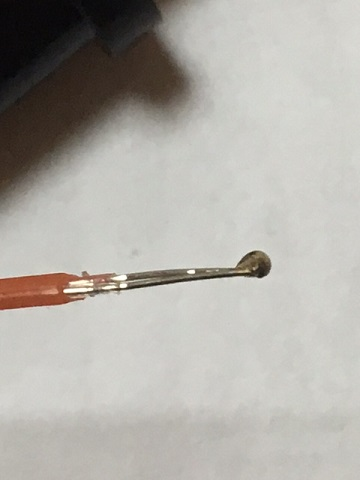
control termal/Termo_1.jpg
