AMSAT-EA/easat-2/control termal/Termo_2.jpg

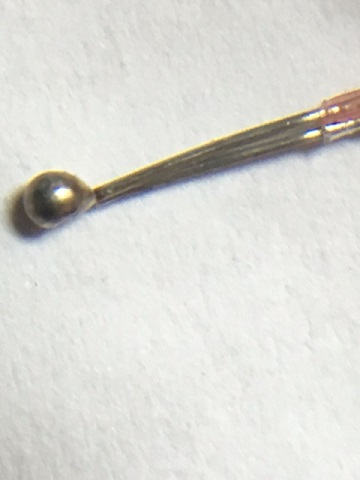
control termal/Termo_2.jpg
