AMSAT-EA/easat-2/datasheets/DRA_ARDUINO.jpg

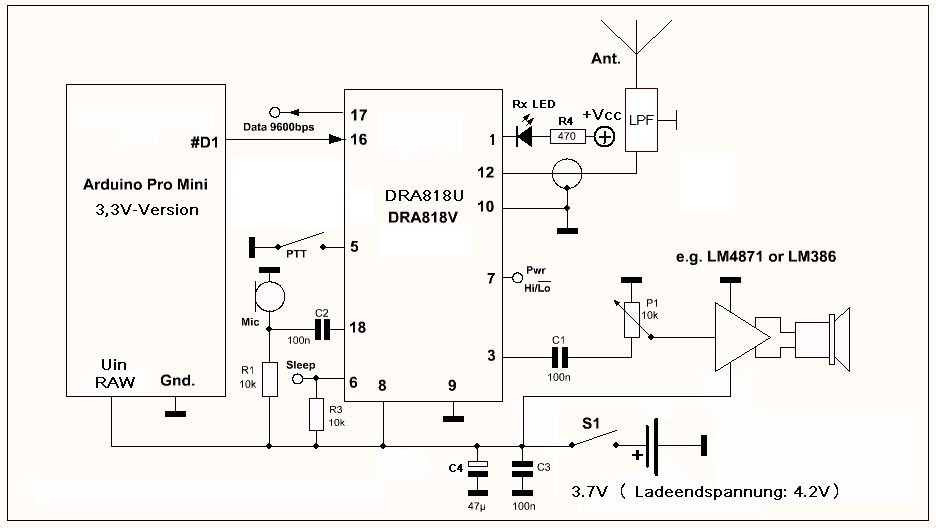
datasheets/DRA_ARDUINO.jpg
