AMSAT-EA/easat-2/datasheets/DRA_PINOUT.png

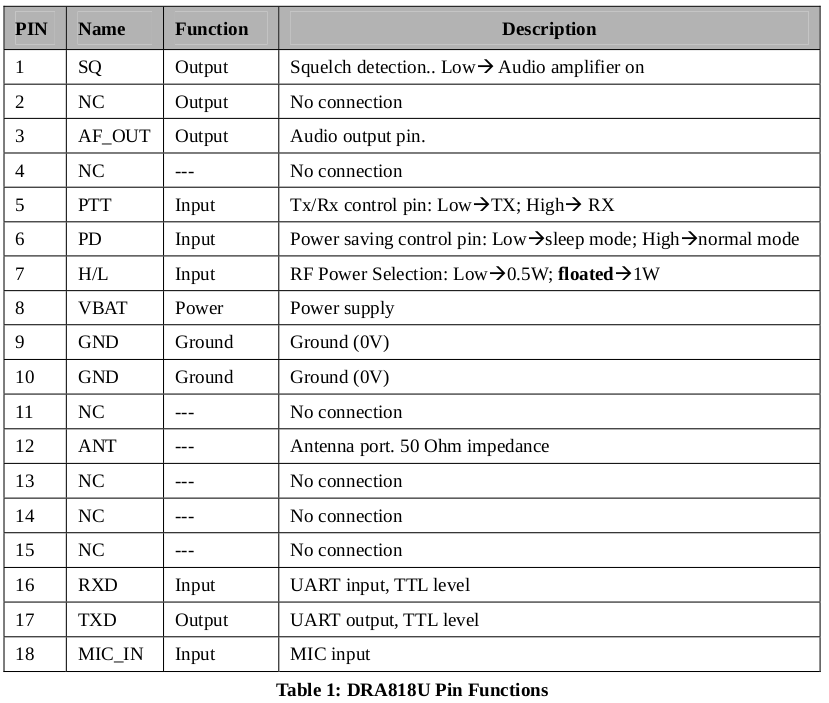
datasheets/DRA_PINOUT.png
