AMSAT-EA/easat-2/datasheets/one-peak-detector.png

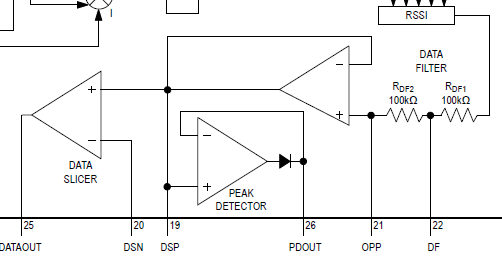
datasheets/one-peak-detector.png
