AMSAT-EA/easat-2/datasheets/two-peakdetectors.png

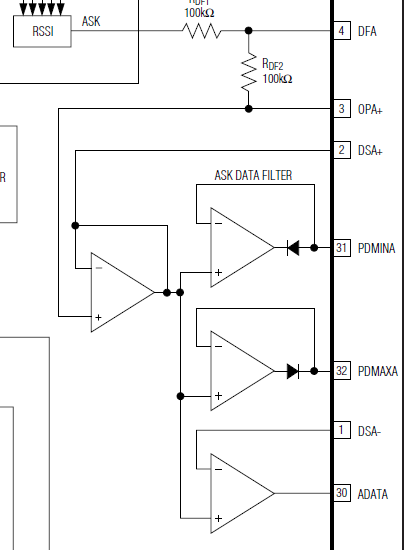
datasheets/two-peakdetectors.png
