AMSAT-EA/easat-2/unidad.antena/antenas.jpg

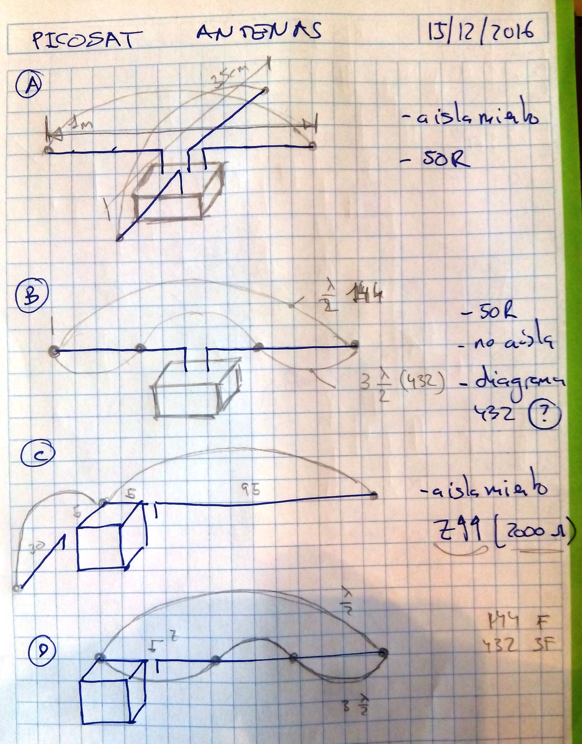
unidad.antena/antenas.jpg
