AMSAT-EA/easat-2/unidad.antena/duplexor1-basico.jpg

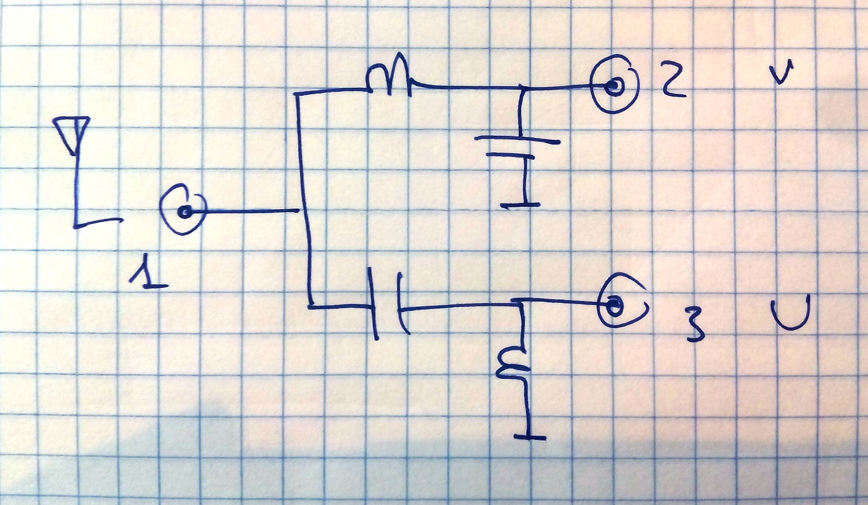
unidad.antena/duplexor1-basico.jpg
