AMSAT-EA/easat-2/unidad.antena/duplexor2-BPFRX-LPFTX.jpg

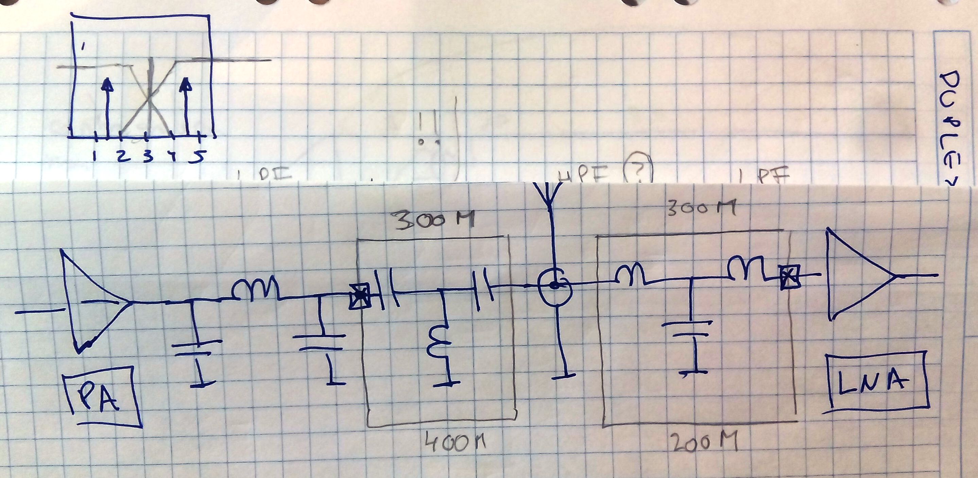
unidad.antena/duplexor2-BPFRX-LPFTX.jpg
