AMSAT-EA/easat-2/unidad.antena/duplexor3-adaptador-alta-z.jpg

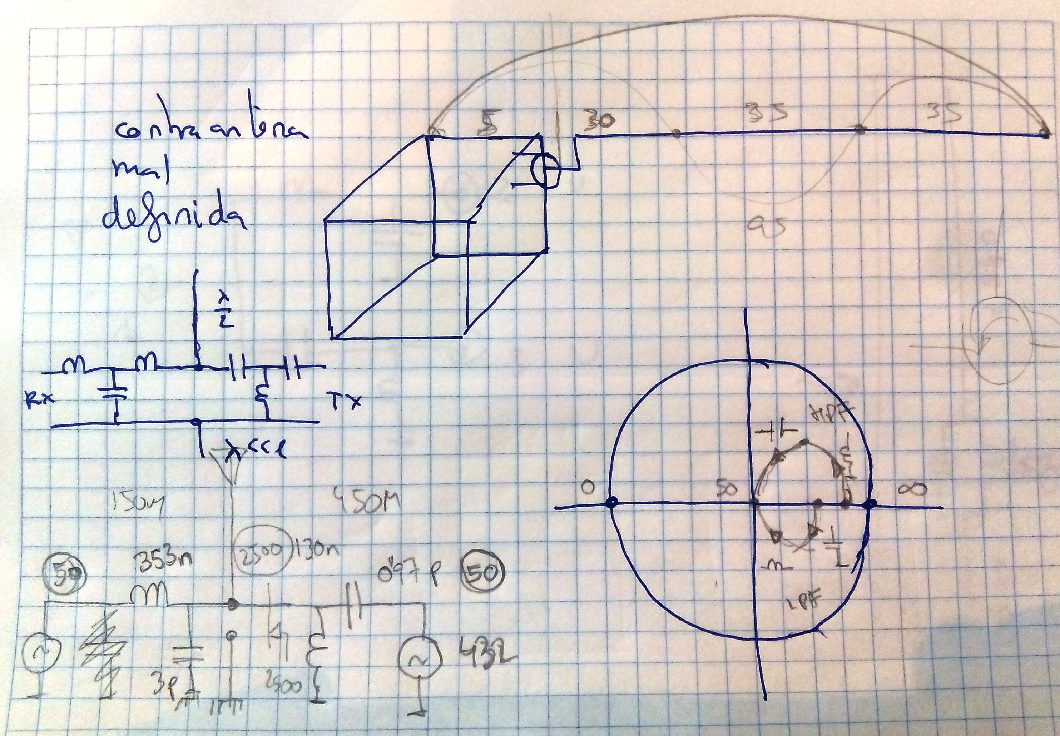
unidad.antena/duplexor3-adaptador-alta-z.jpg
