AMSAT-EA/easat-2/unidad.antena/soporte-barazos-dipolos.jpg

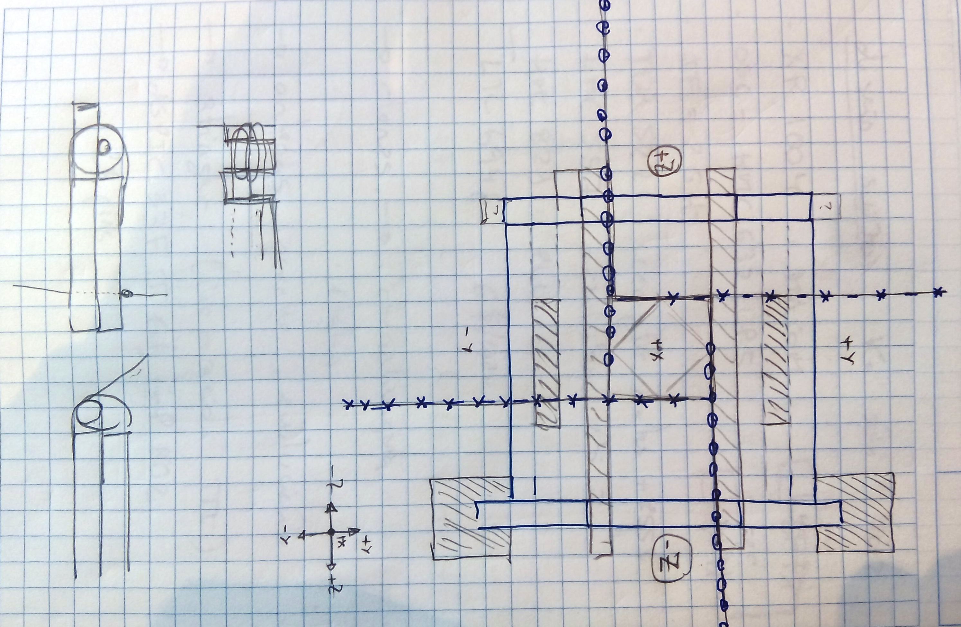
unidad.antena/soporte-barazos-dipolos.jpg
