AMSAT-EA/easat-2/hardware/IHU/librerias/User Library-RM254_5pin.STEP

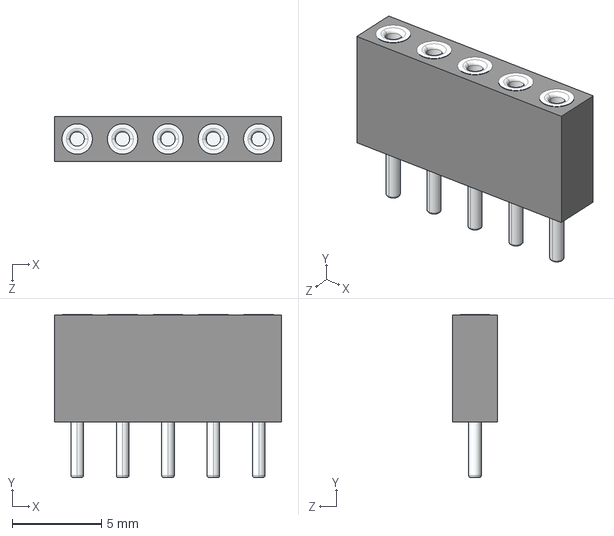
[picture p164: CAD file, 2017-11-04]
hardware/IHU/librerias/User Library-RM254_5pin.STEP
12.7 x 9.12 x 2.54 mm
