AMSAT-EA/easat-2/unidad.estructura/16604E02-BASE 50X50.DXF

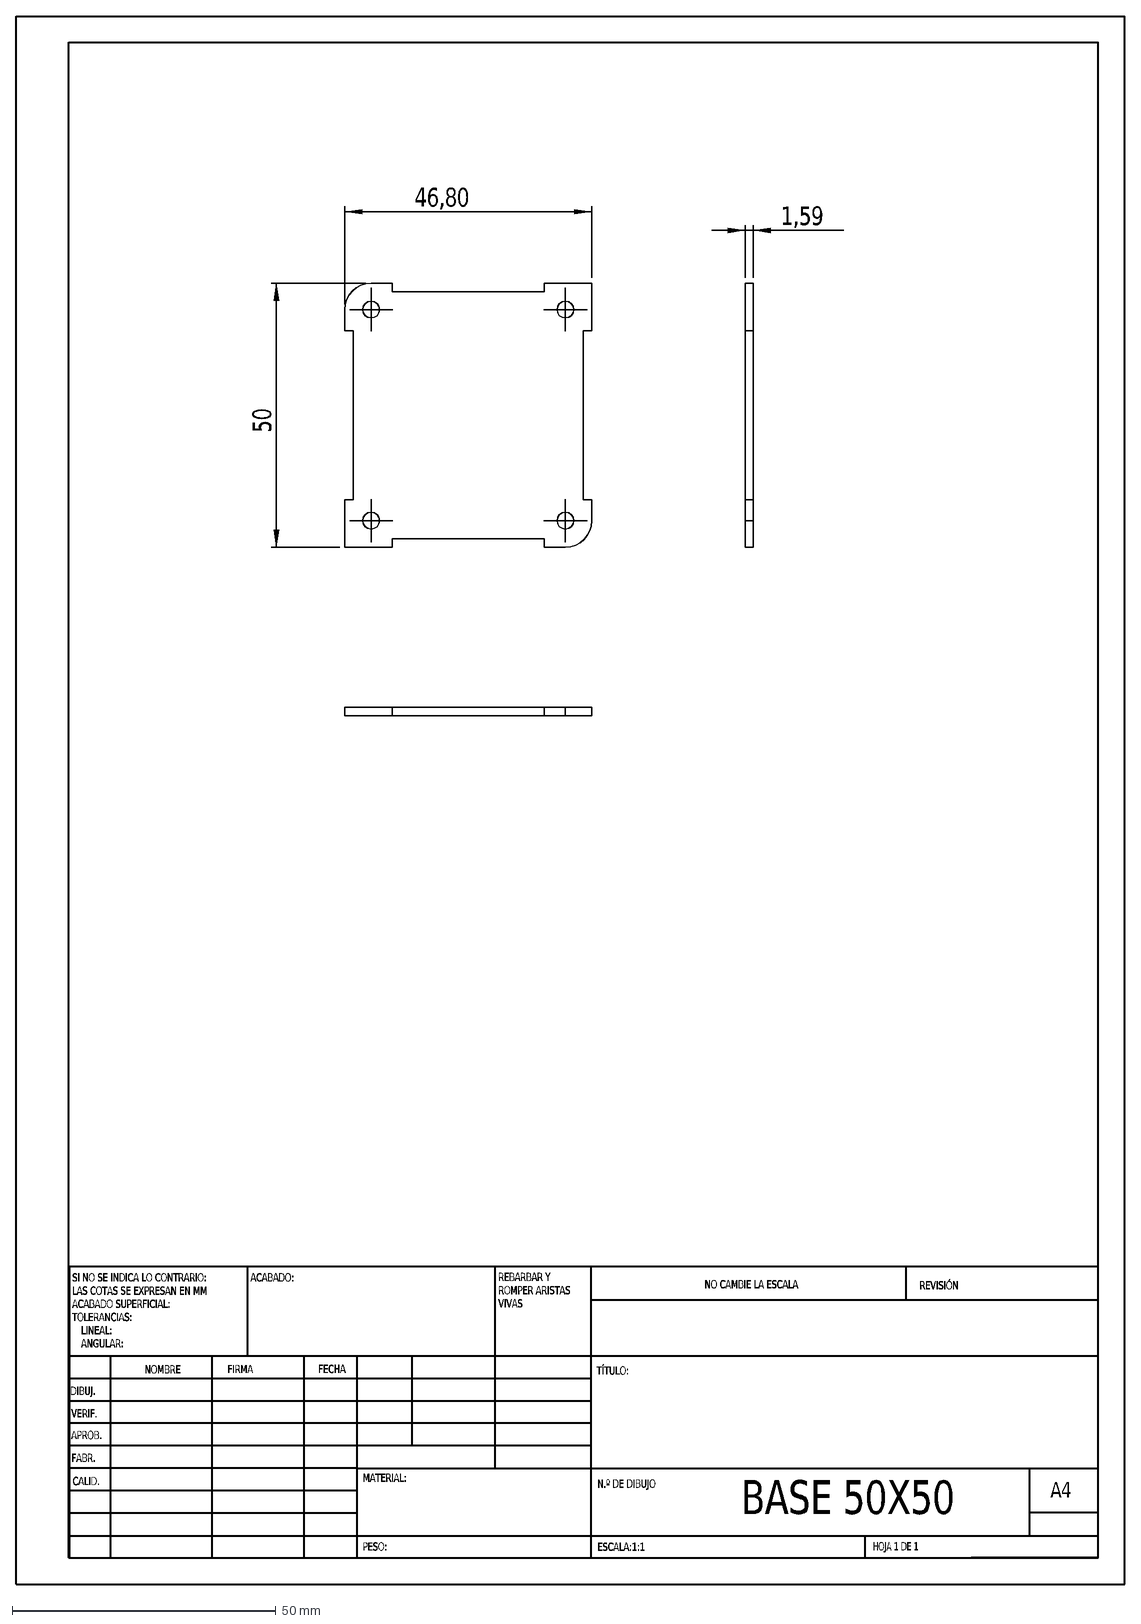
[picture p166: CAD file, 2017-03-11]
unidad.estructura/16604E02-BASE 50X50.DXF
BASE 50X50
PESO:
A4
HOJA 1 DE 1
ESCALA:1:1
N.º DE DIBUJO
TÍTULO:
REVISIÓN
NO CAMBIE LA ESCALA
MATERIAL:
FECHA
FIRMA
NOMBRE
REBARBAR Y
ROMPER ARISTAS
VIVAS
ACABADO:
SI NO SE INDICA LO CONTRARIO:
LAS COTAS SE EXPRESAN EN MM
ACABADO SUPERFICIAL:
TOLERANCIAS:
LINEAL:
ANGULAR:
CALID.
FABR.
APROB.
VERIF.
DIBUJ.
46,80
50
1,59
