AMSAT-EA/easat-2/unidad.estructura/16604E02-LATERAL LATERAL.DXF

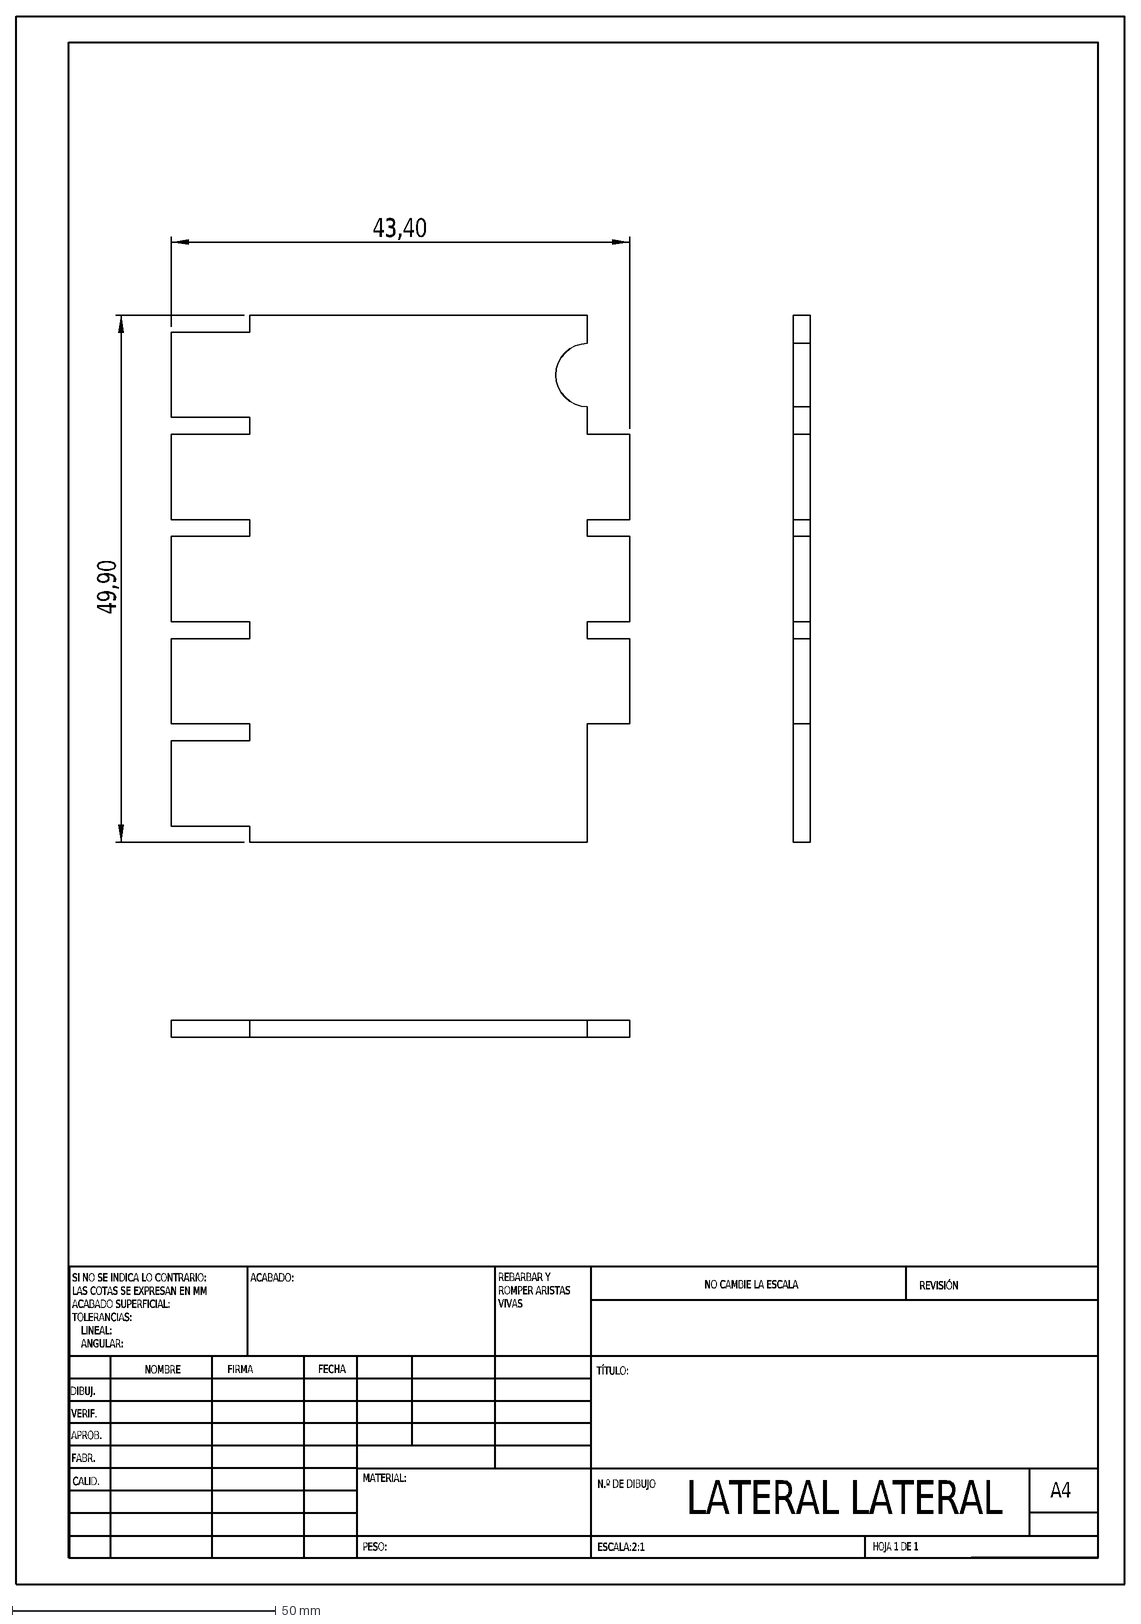
[picture p167: CAD file, 2017-03-11]
unidad.estructura/16604E02-LATERAL LATERAL.DXF
LATERAL LATERAL
PESO:
A4
HOJA 1 DE 1
ESCALA:2:1
N.º DE DIBUJO
TÍTULO:
REVISIÓN
NO CAMBIE LA ESCALA
MATERIAL:
FECHA
FIRMA
NOMBRE
REBARBAR Y
ROMPER ARISTAS
VIVAS
ACABADO:
SI NO SE INDICA LO CONTRARIO:
LAS COTAS SE EXPRESAN EN MM
ACABADO SUPERFICIAL:
TOLERANCIAS:
LINEAL:
ANGULAR:
CALID.
FABR.
APROB.
VERIF.
DIBUJ.
43,40
49,90
