AMSAT-EA/easat-2/unidad.estructura/16604E02-LATERAL FRONTAL.DXF

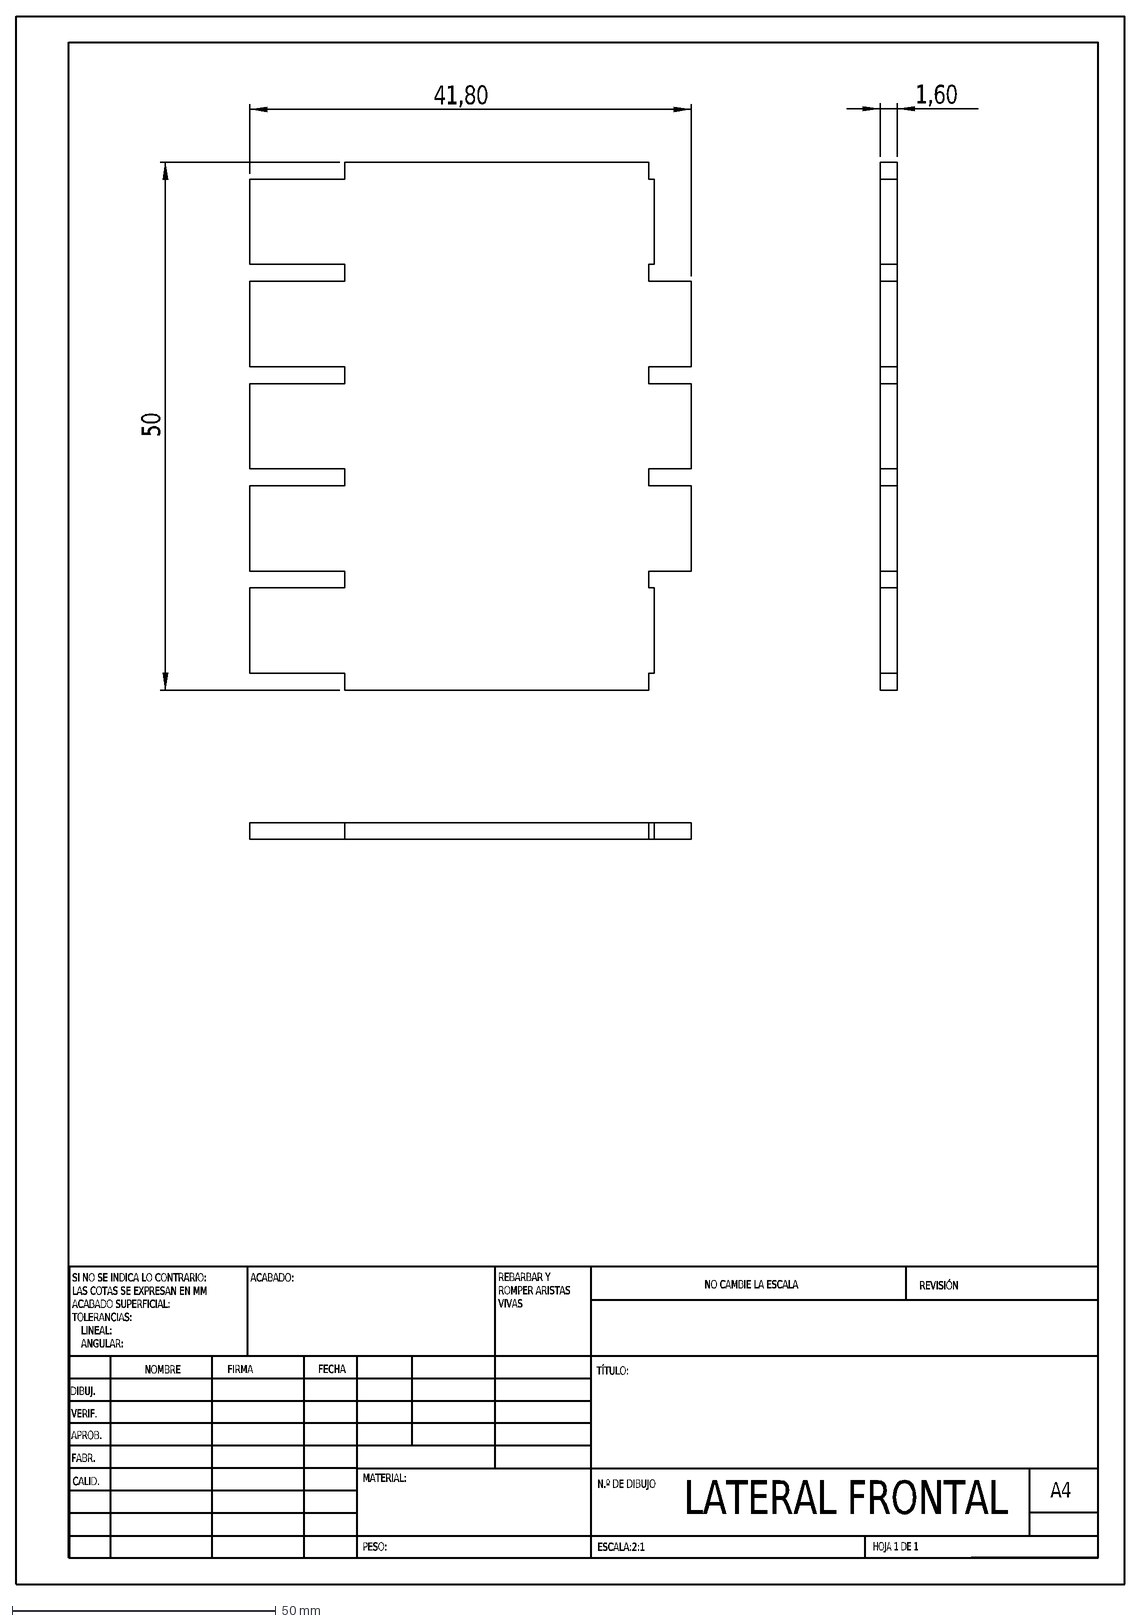
[picture p168: CAD file, 2017-03-11]
unidad.estructura/16604E02-LATERAL FRONTAL.DXF
LATERAL FRONTAL
PESO:
A4
HOJA 1 DE 1
ESCALA:2:1
N.º DE DIBUJO
TÍTULO:
REVISIÓN
NO CAMBIE LA ESCALA
MATERIAL:
FECHA
FIRMA
NOMBRE
REBARBAR Y
ROMPER ARISTAS
VIVAS
ACABADO:
SI NO SE INDICA LO CONTRARIO:
LAS COTAS SE EXPRESAN EN MM
ACABADO SUPERFICIAL:
TOLERANCIAS:
LINEAL:
ANGULAR:
CALID.
FABR.
APROB.
VERIF.
DIBUJ.
41,80
50
1,60
