AMSAT-EA/easat-2/(list of files, cad)

Other CAD files:
software/official/ASK tester/dist/default/production/EASAT2-ASK-TESTER.X.production.obj
software/official/main_project/dist/default/production/EASAT2-MCU-C.X.production.obj
unidad.estructura/16604E01-estructura-y-lanzador.dxf
unidad.estructura/16604E02-0estructura3d.dxf
