AMSAT-EA/easat-2/hardware/IHU/Documentos/Esquematicos/MCU.pdf

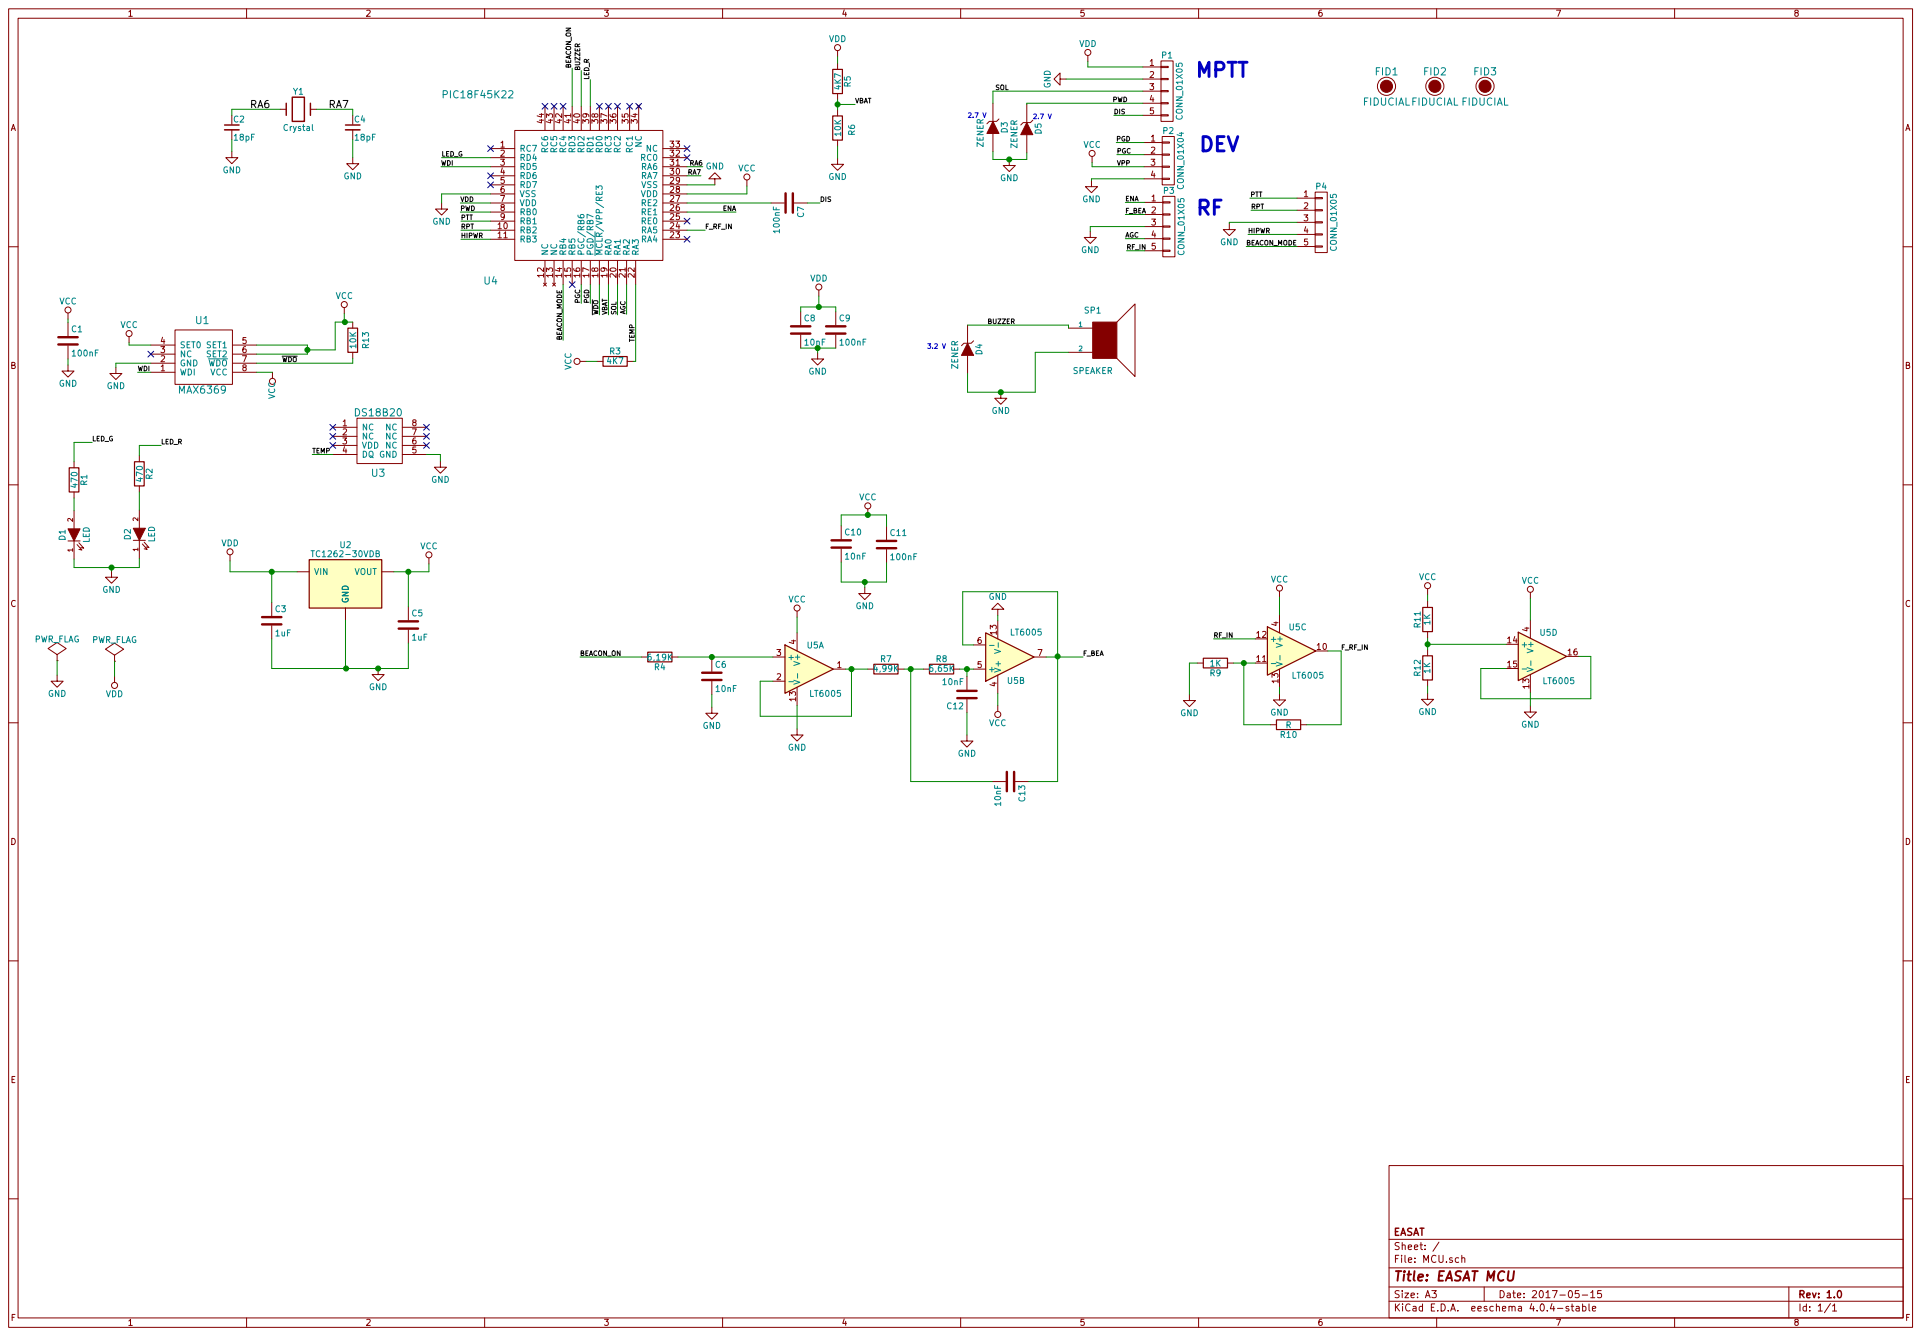
[picture p307: page 1]

PTT RPT HIPWR GND BEACON_MODE GND GND GND D4 ZENER

File: MCU.sch Sheet: / EASAT

Id: 1/1 Title: EASAT MCU
