AMSAT-EA/easat-2/unidad.transponder/trx-bloques-r5.pdf

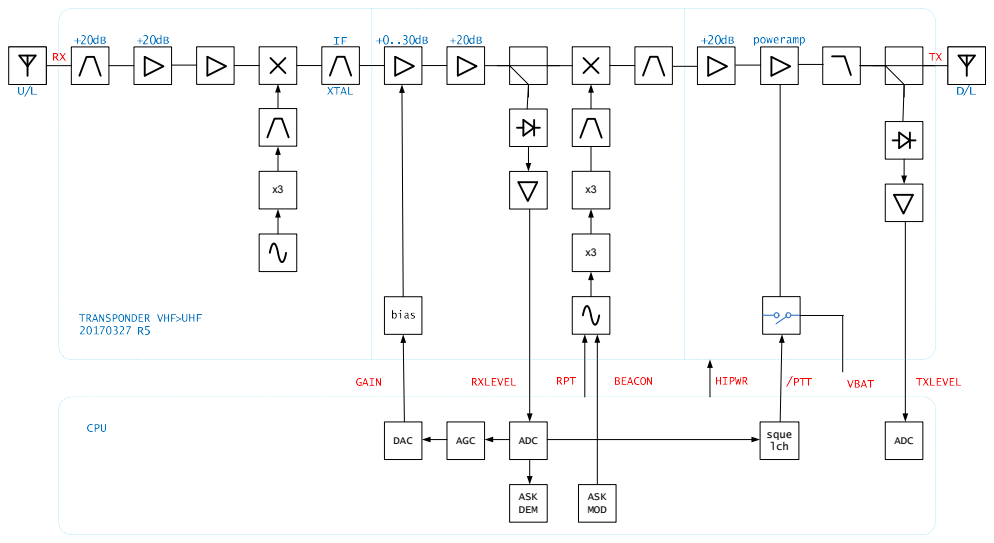
[picture p308: page 1]
ASK DEM; AGC; sque; lch DAC; ADC; ASK MOD
