AMSAT-EA/easat-2/hardware/EPS/EASAT2-EPS.pdf

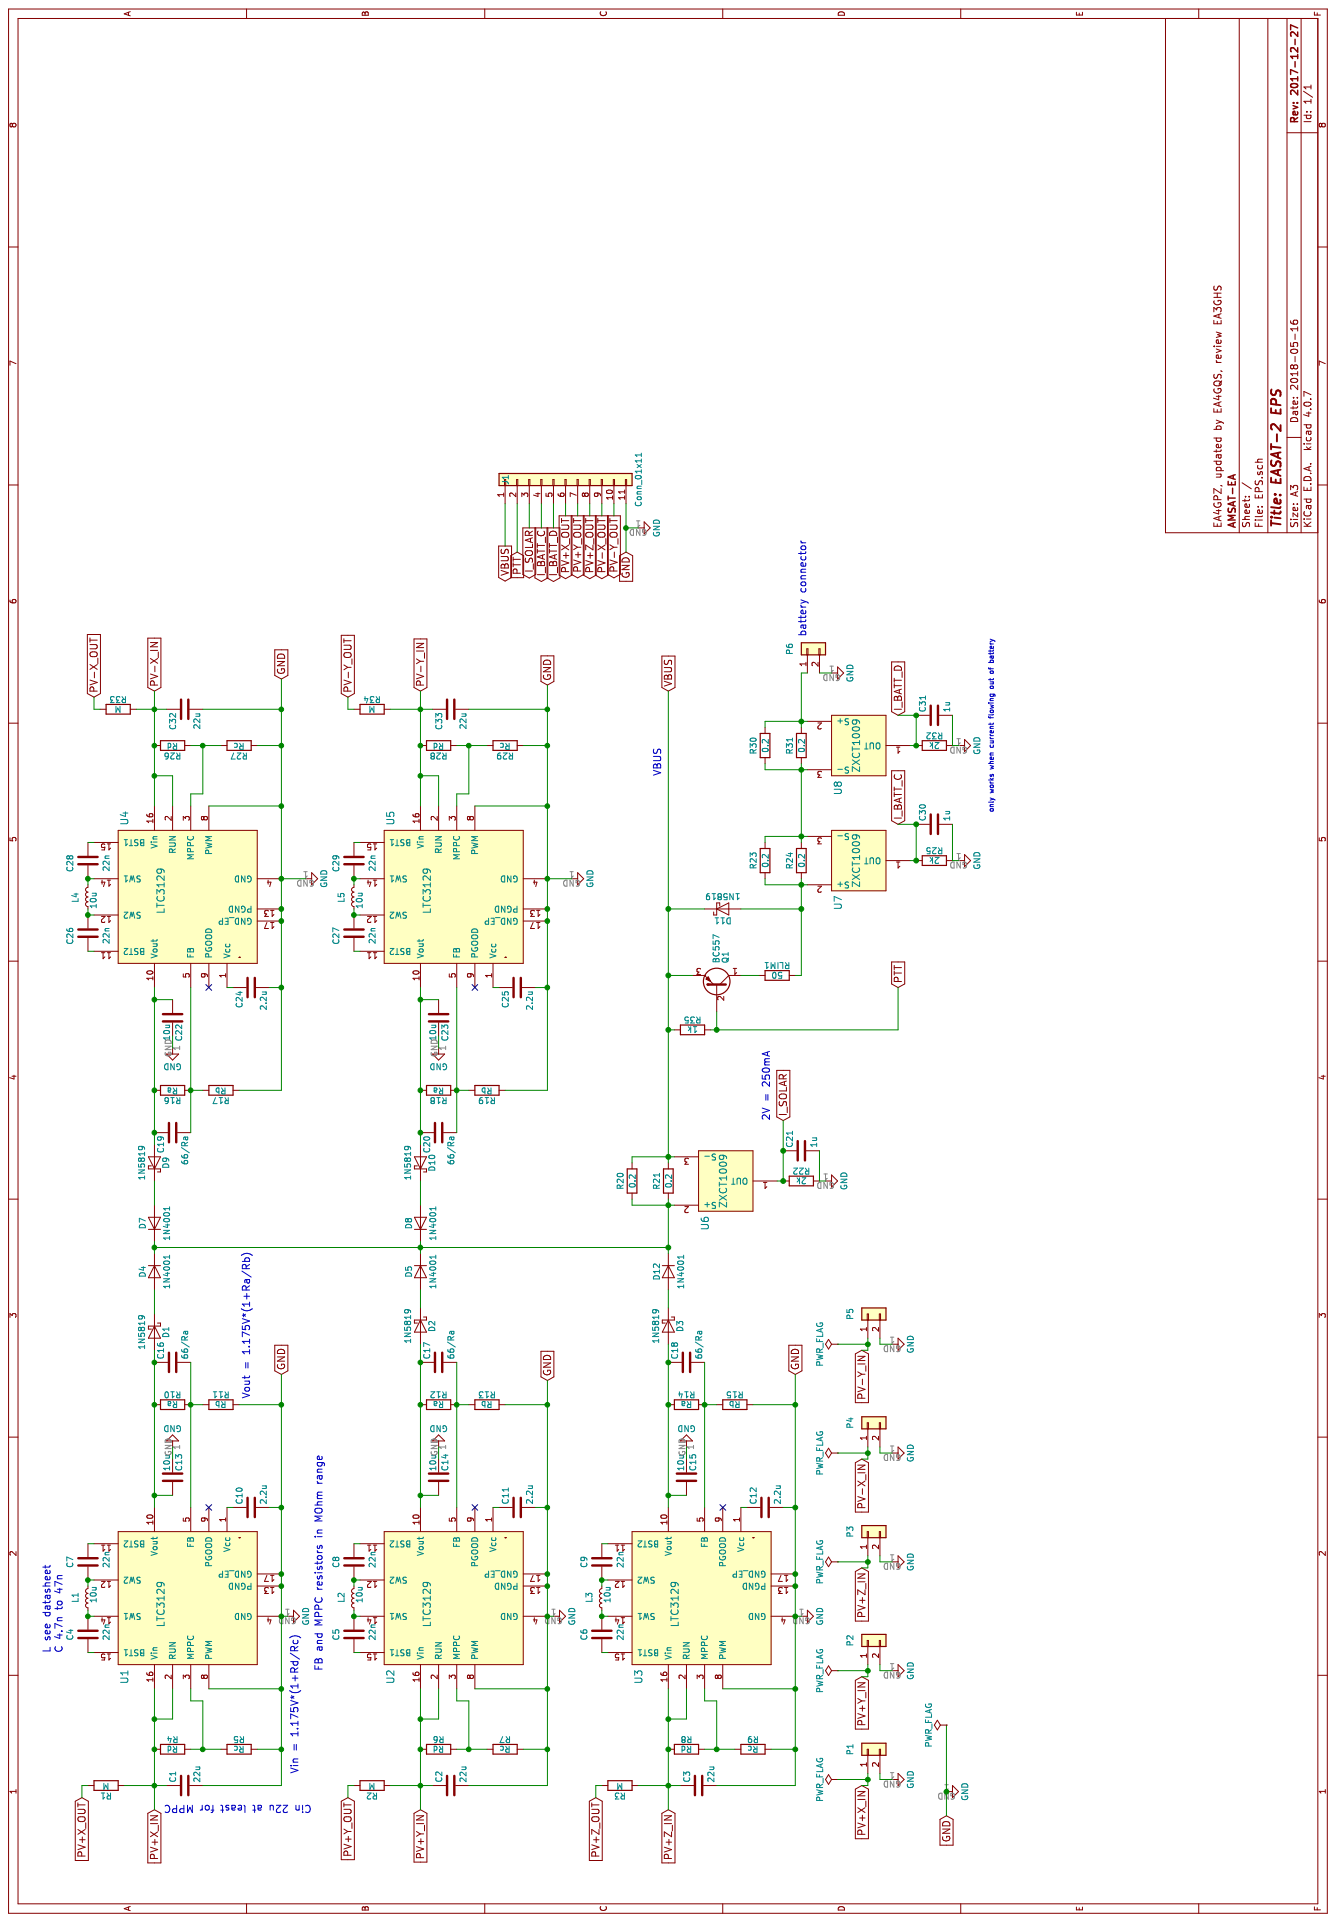
[picture p309: page 1]
