AMSAT-EA/easat-2/hardware/Simulaciones/LPF 1 KHz/LPF 1KHz.asc

C1: cap; 10nF
C2: cap; 10nF
C3: cap; 11nF
R1: res; 6.190K
R2: res; 4.99K
R3: res; 6.650K
U1: LT6221
U3: LT6221
V1: voltage; 3
V2: voltage; PULSE(0 2 0 0.01ms 0.01ms 0.5ms 1ms); AC 1
Named nets: 0, VCC, Vcc
.tran 0 10ms 1ms 1ms
