AMSAT-EA/easat-2/hardware/EPS/EPS.kicad_pcb

## KiCad design hardware/EPS/EPS.kicad_pcb (2018-05-30)

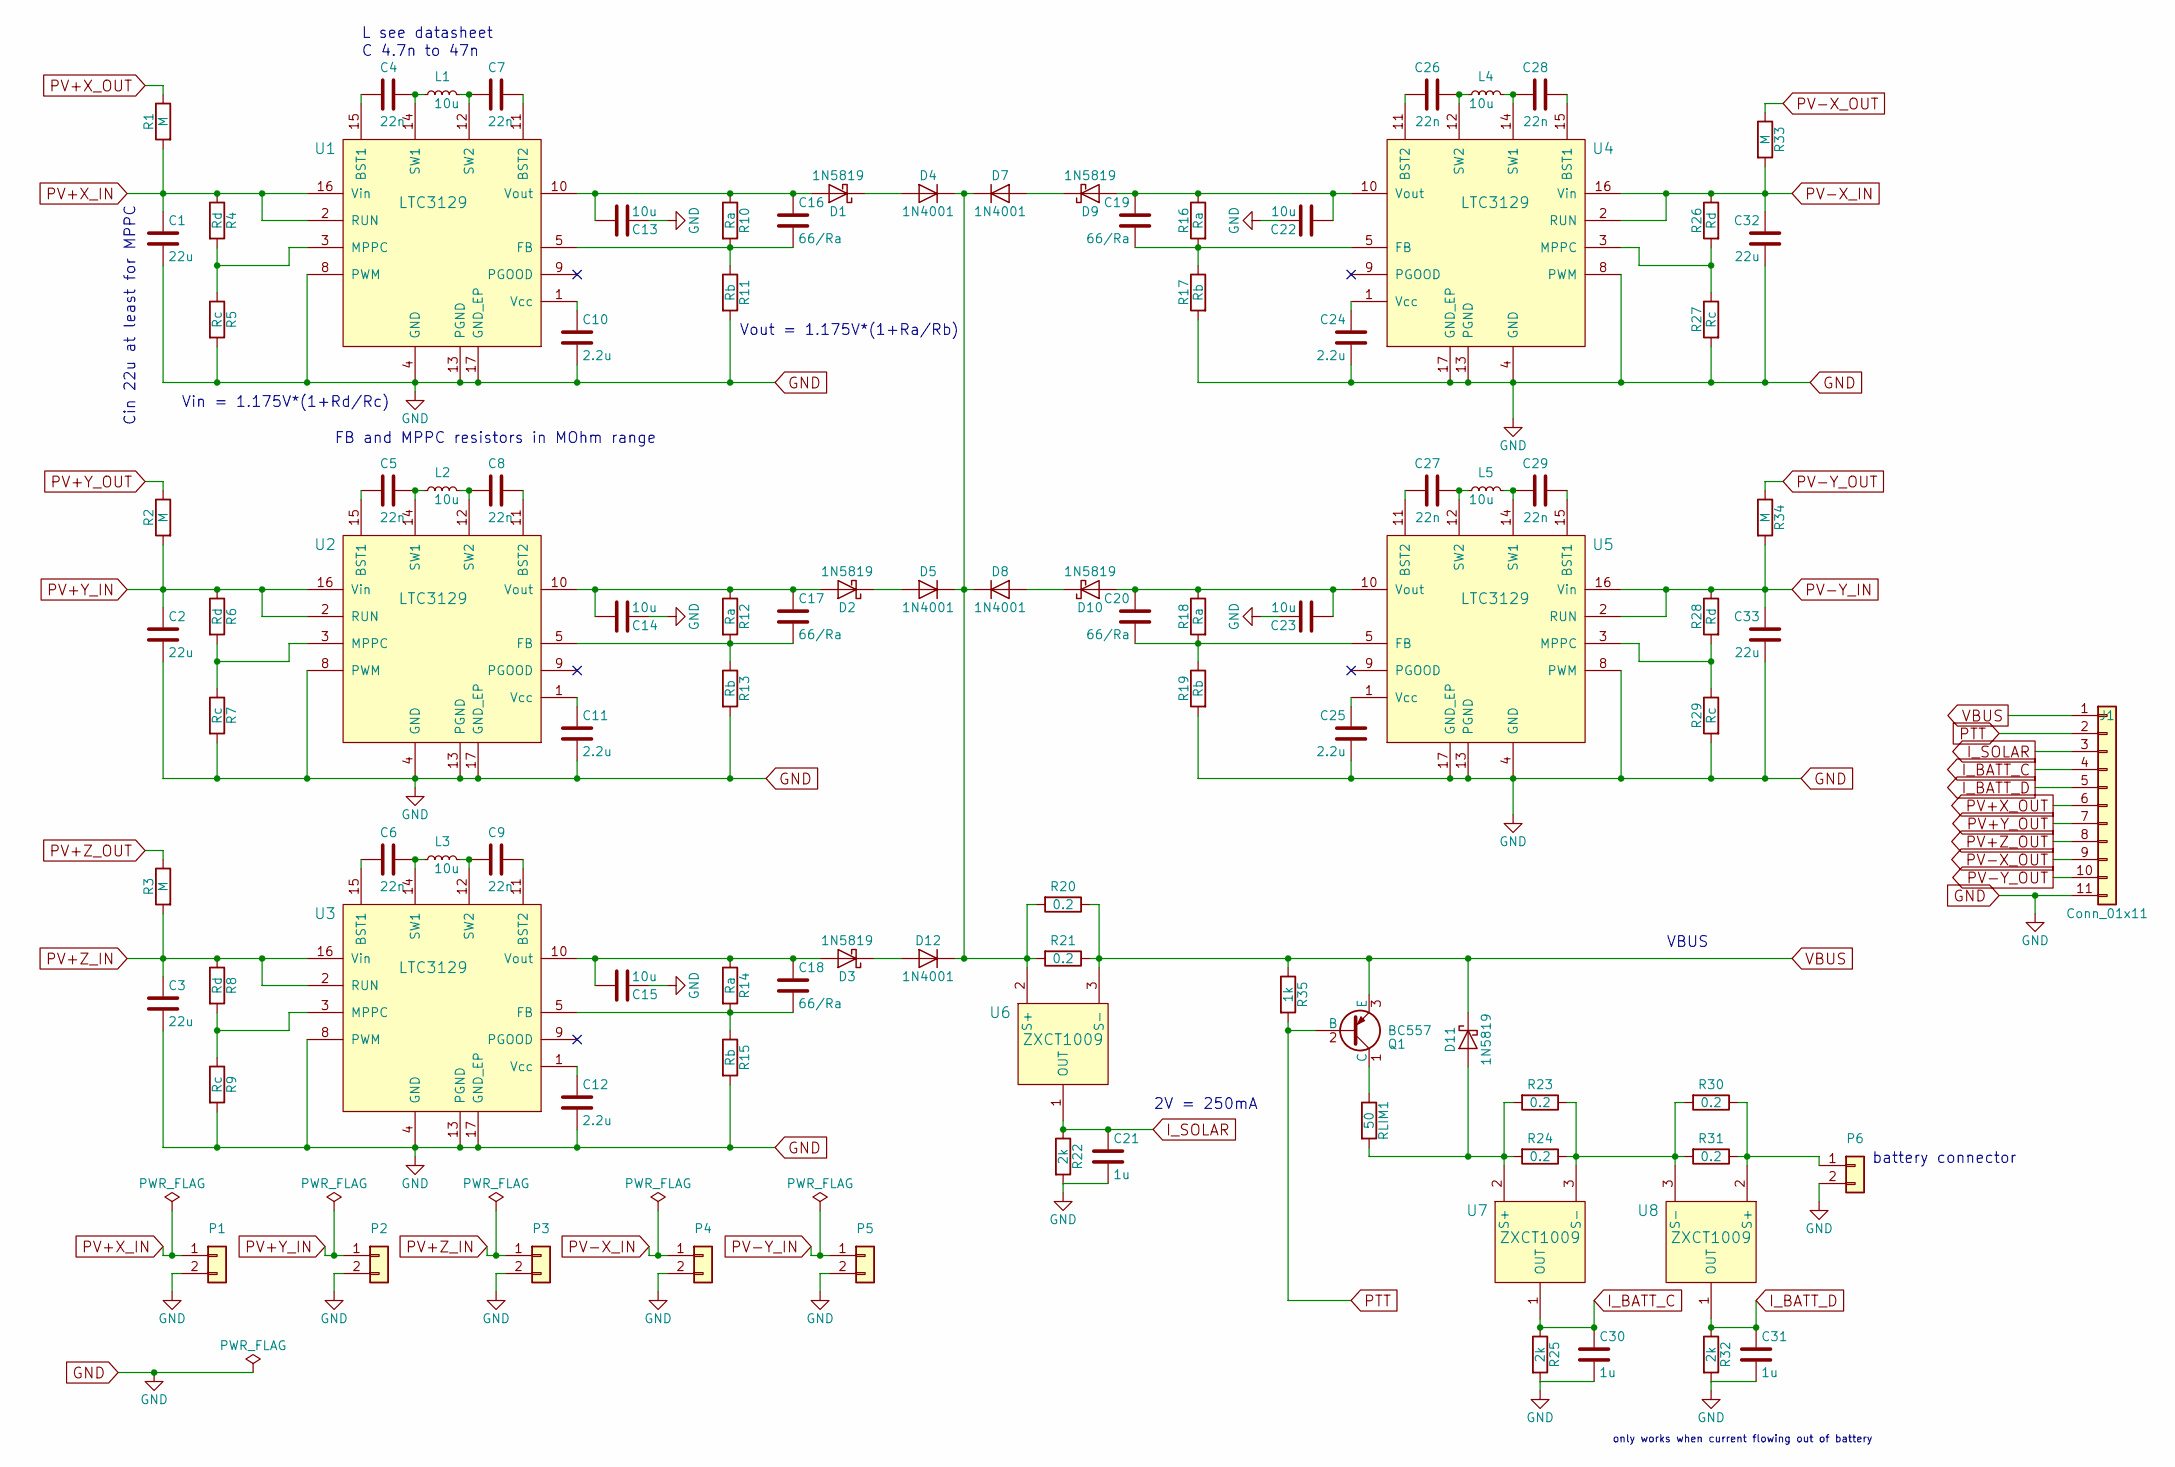
[picture p310: schematic EPS.sch, EASAT-2 EPS]

Parts:
C1, C2, C3, C32, C33: 22u; C_1210; Digikey 1276-3395-1-ND
C4, C5, C6, C7, C8, C9, C26, C27, C28, C29: 22n; C_0603
C10, C11, C12, C24, C25: 2.2u; C_0603; Digikey 1276-2017-1-ND
C13, C14, C15, C22, C23: 10u; C_0805; Digikey 1276-1113-1-ND
C16, C17, C18, C19, C20: 66/Ra; C_0603
C21, C30, C31: 1u; C_0603; Digikey 1276-6524-1-ND
D1, D2, D3, D9, D10, D11: 1N5819; SMini2-F4-B-B; Digikey DB2130200LCT-ND
D4, D5, D7, D8, D12: 1N4001; D_SOD-523
J1: Conn_01x11; Pin_Header_Straight_1x11_Pitch1.27mm
L1, L2, L3, L4, L5: 10u; Murata_LQH32P_footprint
P1, P2, P3, P4, P5, P6: CONN_01X02; Pin_Header_Straight_1x02_Pitch1.27mm
Q1: BC557; TO-92_Molded_Narrow
R1, R2, R3, R33, R34: M; R_0603
R4, R6, R8, R26, R28: Rd; R_0603
R5, R7, R9, R27, R29: Rc; R_0603
R10, R12, R14, R16, R18: Ra; R_0603
R11, R13, R15, R17, R19: Rb; R_0603
R20, R21, R23, R24, R30, R31: 0.2; R_1206; Digikey 311-.4LWCT-ND
R22, R25, R32: 2k; R_0603
R35: 1k; R_0603
RLIM1: 50; R_0603
U1, U2, U3, U4, U5: LTC3129; MSOP-16-Pitch0.5mm_LT3129
U6, U7, U8: ZXCT1009; SOT-23

Connections:
GND: C1.2, C2.2, C3.2, C10.2, C11.2, C12.2, C13.1, C14.1, C15.1, C21.2, C22.1, C23.1, C24.2, C25.2, C30.2, C31.2, C32.2, C33.2, J1.11, P1.2, P2.2, P3.2, P4.2, P5.2, P6.2, R5.2, R7.2, R9.2, R11.2, R13.2, R15.2, R17.2, R19.2, R22.2, R25.2, R27.2, R29.2, R32.2, U1.4 (GND), U1.6, U1.7, U1.8 (PWM), U1.13 (PGND), U1.17 (GND_EP), U2.4 (GND), U2.6, U2.7, U2.8 (PWM), U2.13 (PGND), U2.17 (GND_EP), U3.4 (GND), U3.6, U3.7, U3.8 (PWM), U3.13 (PGND), U3.17 (GND_EP), U4.4 (GND), U4.6, U4.7, U4.8 (PWM), U4.13 (PGND), U4.17 (GND_EP), U5.4 (GND), U5.6, U5.7, U5.8 (PWM), U5.13 (PGND), U5.17 (GND_EP)
I_BATT_C: C30.1, J1.4, R25.1, U7.1 (OUT)
I_BATT_D: C31.1, J1.5, R32.1, U8.1 (OUT)
I_SOLAR: C21.1, J1.3, R22.1, U6.1 (OUT)
unnamed: C4.1, L1.1, U1.14 (SW1)
unnamed: C4.2, U1.15 (BST1)
unnamed: C5.1, L2.1, U2.14 (SW1)
unnamed: C5.2, U2.15 (BST1)
unnamed: C6.1, L3.1, U3.14 (SW1)
unnamed: C6.2, U3.15 (BST1)
unnamed: C7.1, U1.11 (BST2)
unnamed: C7.2, L1.2, U1.12 (SW2)
unnamed: C8.1, U2.11 (BST2)
unnamed: C8.2, L2.2, U2.12 (SW2)
unnamed: C9.1, U3.11 (BST2)
unnamed: C9.2, L3.2, U3.12 (SW2)
unnamed: C10.1, U1.1 (Vcc)
unnamed: C11.1, U2.1 (Vcc)
unnamed: C12.1, U3.1 (Vcc)
unnamed: C13.2, C16.1, D1.2 (A), R10.1, U1.10 (Vout)
unnamed: C14.2, C17.1, D2.2 (A), R12.1, U2.10 (Vout)
unnamed: C15.2, C18.1, D3.2 (A), R14.1, U3.10 (Vout)
unnamed: C16.2, R10.2, R11.1, U1.5 (FB)
unnamed: C17.2, R12.2, R13.1, U2.5 (FB)
unnamed: C18.2, R14.2, R15.1, U3.5 (FB)
unnamed: C19.1, C22.2, D9.2 (A), R16.1, U4.10 (Vout)
unnamed: C19.2, R16.2, R17.1, U4.5 (FB)
unnamed: C20.1, C23.2, D10.2 (A), R18.1, U5.10 (Vout)
unnamed: C20.2, R18.2, R19.1, U5.5 (FB)
unnamed: C24.1, U4.1 (Vcc)
unnamed: C25.1, U5.1 (Vcc)
unnamed: C26.1, U4.11 (BST2)
unnamed: C26.2, L4.2, U4.12 (SW2)
unnamed: C27.1, U5.11 (BST2)
unnamed: C27.2, L5.2, U5.12 (SW2)
unnamed: C28.1, L4.1, U4.14 (SW1)
unnamed: C28.2, U4.15 (BST1)
unnamed: C29.1, L5.1, U5.14 (SW1)
unnamed: C29.2, U5.15 (BST1)
unnamed: D1.1 (K), D4.2 (A)
unnamed: D2.1 (K), D5.2 (A)
unnamed: D7.2 (A), D9.1 (K)
unnamed: D8.2 (A), D10.1 (K)
unnamed: D11.2 (A), R23.2, R24.2, RLIM1.2, U7.2 (S+)
unnamed: D4.1 (K), D5.1 (K), D7.1 (K), D8.1 (K), D12.1 (K), R20.2, R21.2, U6.2 (S+)
unnamed: D3.1 (K), D12.2 (A)
unnamed: P6.1, R30.1, R31.1, U8.2 (S+)
unnamed: Q1.1 (C), RLIM1.1
unnamed: R4.2, R5.1, U1.3 (MPPC)
unnamed: R6.2, R7.1, U2.3 (MPPC)
unnamed: R8.2, R9.1, U3.3 (MPPC)
unnamed: R23.1, R24.1, R30.2, R31.2, U7.3 (S-), U8.3 (S-)
unnamed: R26.2, R27.1, U4.3 (MPPC)
unnamed: R28.2, R29.1, U5.3 (MPPC)
PTT: J1.2, Q1.2 (B), R35.2
PV+X_IN: C1.1, P1.1, R1.2, R4.1, U1.2 (RUN), U1.16 (Vin)
PV+X_OUT: J1.6, R1.1
PV+Y_IN: C2.1, P2.1, R2.2, R6.1, U2.2 (RUN), U2.16 (Vin)
PV+Y_OUT: J1.7, R2.1
PV+Z_IN: C3.1, P3.1, R3.2, R8.1, U3.2 (RUN), U3.16 (Vin)
PV+Z_OUT: J1.8, R3.1
PV-X_IN: C32.1, P4.1, R26.1, R33.2, U4.2 (RUN), U4.16 (Vin)
PV-X_OUT: J1.9, R33.1
PV-Y_IN: C33.1, P5.1, R28.1, R34.2, U5.2 (RUN), U5.16 (Vin)
PV-Y_OUT: J1.10, R34.1
VBUS: D11.1 (K), J1.1, Q1.3 (E), R20.1, R21.1, R35.1, U6.3 (S-)

Notes on the sheet:
Cin 22u at least for MPPC
Vin = 1.175V*(1+Rd/Rc)
FB and MPPC resistors in MOhm range
C 4.7n to 47n
L see datasheet
Vout = 1.175V*(1+Ra/Rb)
battery connector
only works when current flowing out of battery
2V = 250mA
VBUS

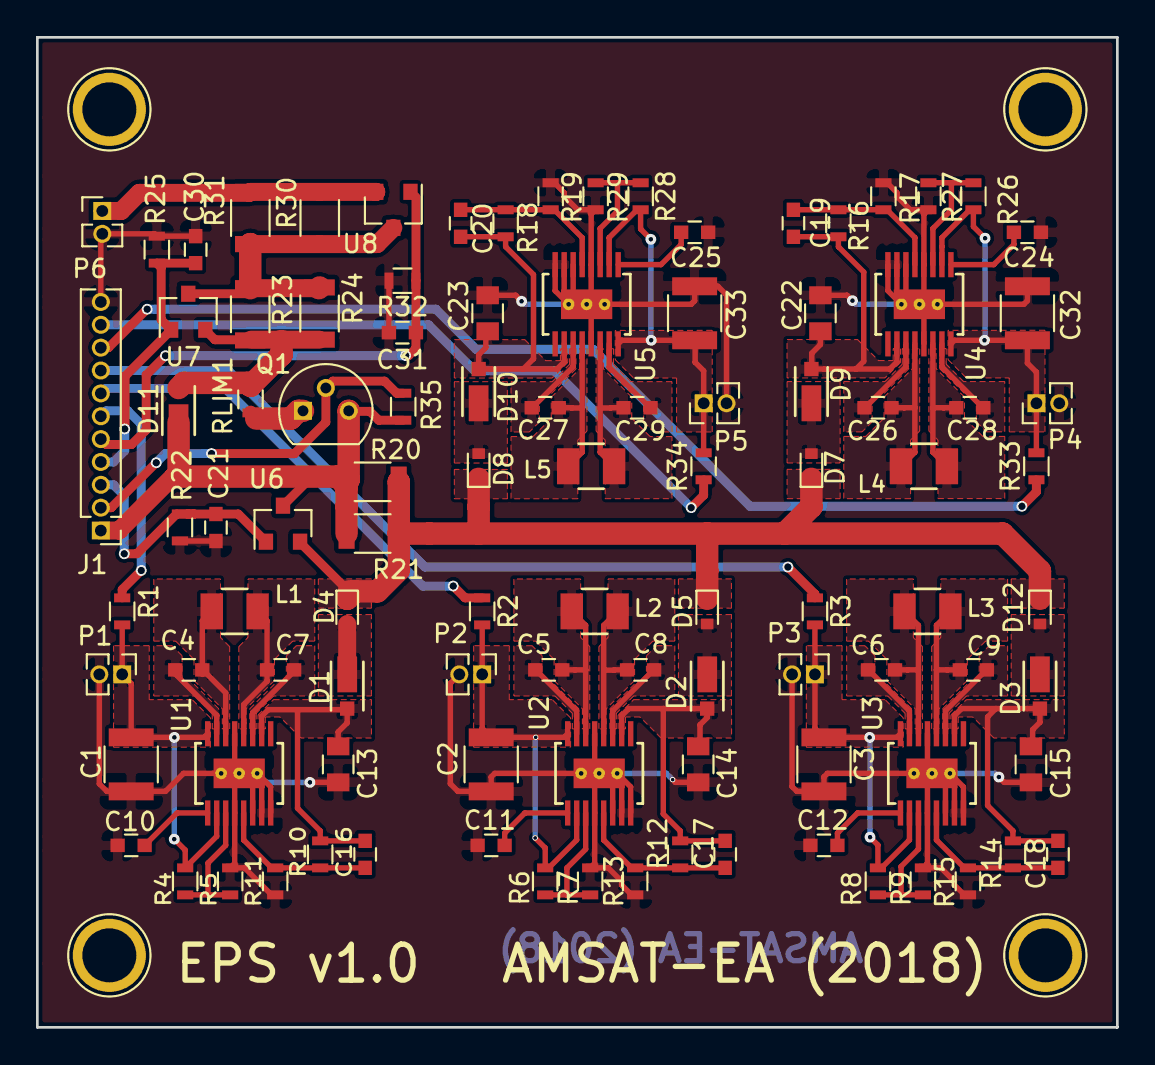
[picture p311: board EPS.kicad_pcb from above]

Board: 2 copper layers, 60.0 x 55.0 mm, 101 parts (0 on the bottom side), 66 nets.
