AMSAT-EA/easat-2/hardware/IHU/MCU.kicad_pcb

## KiCad design hardware/IHU/MCU.kicad_pcb (2018-03-03)

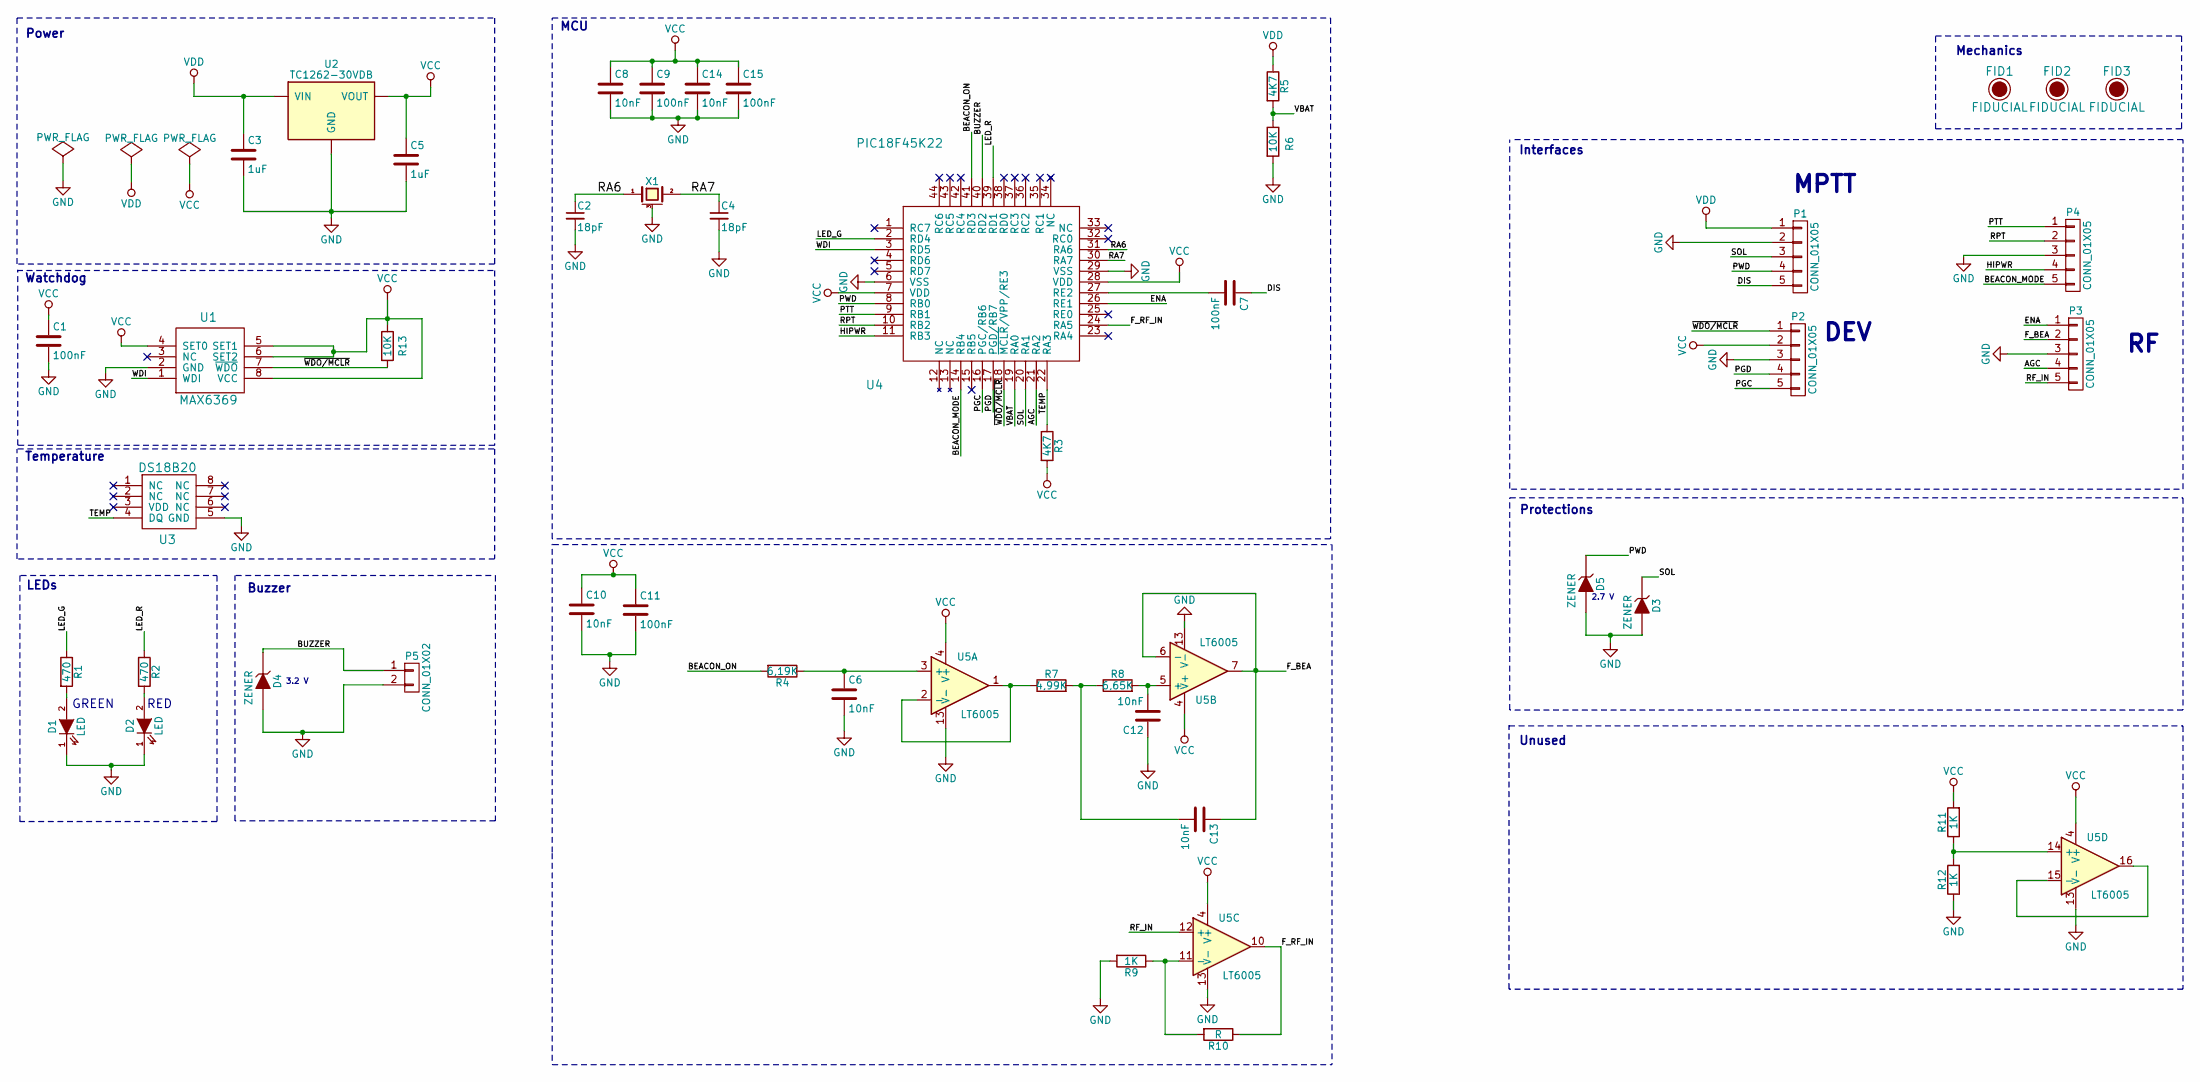
[picture p312: schematic MCU.sch, EASAT MCU]

Parts:
C1, C7, C9, C11, C15: 100nF; C_0603_HandSoldering
C2, C4: 18pF; C_0603_HandSoldering
C3, C5: 1uF; C_0603_HandSoldering
C6, C8, C10, C12, C13, C14: 10nF; C_0603_HandSoldering
D1, D2: LED; LED_1206
D3, D5: ZENER; D_SOD-123
D4: ZENER; D_SOD-323_HandSoldering
FID1, FID2, FID3: FIDUCIAL; Fiducial_1mm_Dia_2.54mm_Outer_CopperTop
P1, P2, P3, P4: CONN_01X05; Molex_MicroLatch-53253-0570_05x2.00mm_Straight
P5: CONN_01X02; Molex_KK-6410-02_02x2.54mm_Straight
R1, R2: 470; R_0603_HandSoldering
R3, R5: 4K7; R_0603_HandSoldering
R4: 6,19K; R_0603_HandSoldering
R6, R13: 10K; R_0603_HandSoldering
R7: 4,99K; R_0603_HandSoldering
R8: 6,65K; R_0603_HandSoldering
R9, R11, R12: 1K; R_0603_HandSoldering
R10: R; R_0603_HandSoldering
U1: MAX6369; SOT-23-8
U2: TC1262-30VDB; SOT-223
U3: DS18B20; MSOP-8_3x3mm_Pitch0.65mm
U4: PIC18F45K22; LQFP-44_10x10mm_Pitch0.8mm
U5: LT6005; SSOP-16_3.9x4.9mm_Pitch0.635mm
X1: CRYSTAL_SMD; Crystal_SMD_0603-4pin_6.0x3.5mm

Connections:
/AGC: P3.4, U4.21 (RA2)
/BEACON_MODE: P4.5, U4.14 (RB4)
/BEACON_ON: R4.2, U4.41 (RD3)
/BUZZER: D4.1 (K), P5.1, U4.40 (RD2)
/DIS: C7.1, P1.5
/ENA: P3.1, U4.26 (RE1)
/F_BEA: P3.2, U5.7
/F_RF_IN: R10.1, U4.24 (RA5), U5.10
/HIPWR: P4.4, U4.11 (RB3)
/LED_G: R1.1, U4.2 (RD4)
/LED_R: R2.1, U4.39 (RD1)
/PGC: P2.5, U4.16 (PGC/RB6)
/PGD: P2.4, U4.17 (PGD/RB7)
/PTT: P4.1, U4.9 (RB1)
/PWD: D5.1 (K), P1.4, U4.8 (RB0)
/RA6: C2.1, U4.31 (RA6), X1.1
/RA7: C4.1, U4.30 (RA7), X1.2
/RF_IN: P3.5, U5.12 (+)
/RPT: P4.2, U4.10 (RB2)
/SOL: D3.1 (K), P1.3, U4.20 (RA1)
/TEMP: R3.1, U3.4 (DQ), U4.22 (RA3)
/VBAT: R5.2, R6.1, U4.19 (RA0)
/WDI: U1.1 (WDI), U4.3 (RD5)
/~WDO/MCLR: P2.1, R13.2, U1.7 (~WDO), U4.18 (~MCLR~/VPP/RE3)
GND: C1.2, C2.2, C3.2, C4.2, C5.2, C6.2, C8.2, C9.2, C10.2, C11.2, C12.1, C14.2, C15.2, D1.1 (K), D2.1 (K), D3.2 (A), D4.2 (A), D5.2 (A), P1.2, P2.3, P3.3, P4.3, P5.2, R6.2, R9.2, R12.1, U1.2 (GND), U2.2 (GND), U2.4 (GND), U3.5 (GND), U4.6 (VSS), U4.29 (VSS), U5.13 (V-), X1.3 (case)
unnamed: C6.1, R4.1, U5.3 (+)
unnamed: C7.2, U4.27 (RE2)
unnamed: C12.2, R8.2, U5.5 (+)
unnamed: C13.1, U5.6 (-)
unnamed: C13.2, R7.2, R8.1
unnamed: D1.2 (A), R1.2
unnamed: D2.2 (A), R2.2
unnamed: R7.1, U5.1, U5.2 (-)
unnamed: R9.1, R10.2, U5.11 (-)
unnamed: R11.1, R12.2, U5.14 (+)
unnamed: U5.15 (-), U5.16
VCC: C1.1, C5.1, C8.1, C9.1, C10.1, C11.1, C14.1, C15.1, P2.2, R3.2, R11.2, R13.1, U1.4 (SET0), U1.5 (SET1), U1.6 (SET2), U1.8 (VCC), U2.3 (VOUT), U4.7 (VDD), U4.28 (VDD), U5.4 (V+)
VDD: C3.1, P1.1, R5.1, U2.1 (VIN)

Notes on the sheet:
MPTT
2.7 V
DEV
3.2 V
Mechanics
Interfaces
Protections
Power
LEDs
MCU
Watchdog
Temperature
Buzzer
Unused
GREEN
RED

Board: 2 copper layers, 47 parts (0 on the bottom side), 38 nets, no tracks yet.
