AMSAT-EA/easat-2/software/official/main_project/easat2.h

/*
 *                                                       
 * Project     : EASAT2                                            
 * File        : easat2.h
 *
 * Description : This file include all the necessary project includes
 * Last update : 07 October 2016                                              
 *                                                                            
*/

#ifndef EASAT2_H
#define	EASAT2_H

#include <xc.h>
#include "easat2_config.h"
#include "easat2_pinouts.h"

#define MIN_TRANSMIT_VOLTAGE        0
#define MAIN_LOOP_SLEEP_MINUTES     3
#define LOW_BATTERY_SLEEP_HOURS     2

#define CHAR_A                      'A'
#define CHAR_B                      'B'
#define CHAR_C                      'C'
#define CHAR_D                      'D'
#define CHAR_E                      'E'
#define CHAR_F                      'F'
#define CHAR_G                      'G'
#define CHAR_H                      'H'
#define CHAR_I                      'I'
#define CHAR_J                      'J'
#define CHAR_K                      'K'
#define CHAR_L                      'L'
#define CHAR_M                      'M'
#define CHAR_N                      'N'
#define CHAR_O                      'O'
#define CHAR_P                      'P'
#define CHAR_Q                      'Q'
#define CHAR_R                      'R'
#define CHAR_S                      'S'
#define CHAR_T                      'T'
#define CHAR_U                      'U'
#define CHAR_V                      'V'
#define CHAR_W                      'W'
#define CHAR_X                      'X'
#define CHAR_Y                      'Y'
#define CHAR_Z                      'Z'

#define DIGIT_0                     '0'
#define DIGIT_1                     '1'
#define DIGIT_2                     '2'
#define DIGIT_3                     '3'
#define DIGIT_4                     '4'
#define DIGIT_5                     '5'
#define DIGIT_6                     '6'
#define DIGIT_7                     '7'
#define DIGIT_8                     '8'
#define DIGIT_9                     '9'

#define SYMBOL_COMMA                ','
#define SYMBOL_QUESTION             '?'
#define SYMBOL_SLASH                '/'
#define SYMBOL_DOT                  '.'
#define SYMBOL_DASH                 '-'
#define SYMBOL_SPACE                ' '

/* morse alphabet definition */

#define MORSE_SEQUENCE_LETTER_A     ".-"
#define MORSE_SEQUENCE_LETTER_B     "-..."
#define MORSE_SEQUENCE_LETTER_C     "-.-."
#define MORSE_SEQUENCE_LETTER_D     "-.."
#define MORSE_SEQUENCE_LETTER_E     "."
#define MORSE_SEQUENCE_LETTER_F     "..-."
#define MORSE_SEQUENCE_LETTER_G     "--."
#define MORSE_SEQUENCE_LETTER_H     "...."
#define MORSE_SEQUENCE_LETTER_I     ".."
#define MORSE_SEQUENCE_LETTER_J     ".---"
#define MORSE_SEQUENCE_LETTER_K     "-.-"
#define MORSE_SEQUENCE_LETTER_L     ".-.."
#define MORSE_SEQUENCE_LETTER_M     "--"
#define MORSE_SEQUENCE_LETTER_N     "-."
#define MORSE_SEQUENCE_LETTER_O     "---"
#define MORSE_SEQUENCE_LETTER_P     ".--."
#define MORSE_SEQUENCE_LETTER_Q     "--.-"
#define MORSE_SEQUENCE_LETTER_R     ".-."
#define MORSE_SEQUENCE_LETTER_S     "..."
#define MORSE_SEQUENCE_LETTER_T     "-"
#define MORSE_SEQUENCE_LETTER_U     "..-"
#define MORSE_SEQUENCE_LETTER_V     "...-"
#define MORSE_SEQUENCE_LETTER_W     ".--"
#define MORSE_SEQUENCE_LETTER_X     "-..-"
#define MORSE_SEQUENCE_LETTER_Y     "-.--"
#define MORSE_SEQUENCE_LETTER_Z     "--.."
#define MORSE_SEQUENCE_DIGIT_0      "-----"
#define MORSE_SEQUENCE_DIGIT_1      ".----"
#define MORSE_SEQUENCE_DIGIT_2      "..---"
#define MORSE_SEQUENCE_DIGIT_3      "...--"
#define MORSE_SEQUENCE_DIGIT_4      "....-"
#define MORSE_SEQUENCE_DIGIT_5      "....."
#define MORSE_SEQUENCE_DIGIT_6      "-...."
#define MORSE_SEQUENCE_DIGIT_7      "--..."
#define MORSE_SEQUENCE_DIGIT_8      "---.."
#define MORSE_SEQUENCE_DIGIT_9      "----."
#define MORSE_SEQUENCE_SYMBOL_COMMA     "--..--"
#define MORSE_SEQUENCE_SYMBOL_QUESTION  "..--.."
#define MORSE_SEQUENCE_SYMBOL_SLASH     "-..-."
#define MORSE_SEQUENCE_SYMBOL_DOT       ".-.-.-"
#define MORSE_SEQUENCE_SYMBOL_DASH      "-....-"


#endif
