AMSAT-EA/easat-2/software/official/main_project/easat2_func_interrupts.h

/*
 *                                                       
 * Project     : EASAT2                                            
 * File        : easat2_func_interrupts.h
 *
 * Description : This file includes all the function prototypes
 * Last update : 07 October 2016                                              
 *                                                                            
*/

#ifndef EASAT2_FUNC_INTERRUPTS
#define EASAT2_FUNC_INTERRUPTS

#include "easat2.h"
#include "easat2_init_timer.h"
#include "easat2_func_commands.h"

#define TMR1_HALF_SECOND                    50    // 50 interrupts is half second  
#define TMR1_CENT_SECOND                    10    // 10 interrupts is a cent of second
#define SAMPLE_TABLE_SIZE                   128   // 128 samples in table (100 in a second)
#define INITIAL_NOISE_MEAN_VALUE            32000 // initial value ADC max is 1024
#define INITIAL_ACTIVACION_THRESHOLD        32000 // initial value ADC max is 1024
#define THRESHOLD_EXCEED_TIMES_ACTIVATION   200   // times thresold has to be exceeded
                                                  // to consider it is a transmission 
                                                  // 200 = 2 seconds

#define MAX_ADC_VALUE                       1024
#define THRESHOLD_NOISE_LEFT_SHIFTS         1     // thresold is calculated with this
                                           

#define REPEATER_ACTIVE_CYCLES              12000 // 2 minutes transmitter active */

#define AVERAGE_NOISE_RIGHT_SHIFTS          7     // divide by 128

// ASK management definitions

#define LOW                                 0
#define HIGH                                1

#define BIT_0                               0
#define BIT_1                               1
#define NOTHING                             2

#define IDLE                                0
#define PROCESSING                          1

// functions prototypes

void interrupt high_priority_int();
void interrupt low_priority low_priority_int();


#endif
