AMSAT-EA/easat-2/software/official/main_project/easat2_init_initialize.h

/*
 *                                                       
 * Project     : EASAT2                                            
 * File        : easat2_init_initialize.h
 *
 * Description : This file includes all the function prototypes
 * Last update : 07 October 2016                                              
 *                                                                            
*/

#ifndef EASAT2_INIT_INITIALIZE
#define EASAT2_INIT_INITIALIZE

#include "easat2.h"

// functions prototypes

void init_watchdogs_initialize(void);
void init_initialize(void);
void init_io_initialize(void);

#endif
