AMSAT-EA/easat-2/software/official/main_project/easat2_main_mcu.h

/*
 *                                                       
 * Project     : EASAT2                                            
 * File        : easat2_main_mcu.h
 *
 * Description : This file includes all the function prototypes
 * Last update : 07 October 2016                                              
 *                                                                            
*/

#ifndef EASAT2_MAIN_MCU
#define EASAT2_MAIN_MCU

#include "easat2.h"

// functions prototypes

void main_loop(void);


#endif
