AMSAT-EA/easat-2/software/official/main_project/easat2_init_timer.h

/*
 *                                                       
 * Project     : EASAT2                                            
 * File        : easat2_init_timer.h
 *
 * Description : This file includes all the function prototypes
 * Last update : 07 October 2016                                              
 *                                                                            
*/

#ifndef EASAT2_INIT_TIMER
#define EASAT2_INIT_TIMER

#include "easat2.h"

#define TIMER1H_VAL 0xEC
#define TIMER1L_VAL 0x77    ; 60535

// functions prototypes

void init_timer1_initialize(void);
void init_timer2_initialize(void);

#endif
