AMSAT-EA/easat-2/software/official/main_project/easat2_func_agc.c

/*
 *                                                       
 * Project     : EASAT2                                            
 * File        : easat2_func_agc.c
 *
 * Description : Functions related to automatic gain control (agc)
 * Last update : 18 January 2017                                              
 *                                                                            
*/

#include "easat2.h"
