AMSAT-EA/easat-2/software/official/main_project/easat2_func_agc.h

/*
 *                                                       
 * Project     : EASAT2                                            
 * File        : easat2_func_agc.h
 *
 * Description : This file includes all the function prototypes
 * Last update : 07 October 2016                                              
 *                                                                            
*/

#ifndef EASAT2_FUNC_AGC
#define EASAT2_FUNC_AGC

#include "easat2.h"

// functions prototypes

#endif
