AMSAT-EA/easat-2/software/official/main_project/easat2_func_energy.c

/*
 *                                                       
 * Project     : EASAT2                                            
 * File        : easat2_func_energy.c
 *
 * Description : Functions related to energy management
 * Last update : 18 January 2017                                              
 *                                                                            
*/

#include "easat2.h"
