AMSAT-EA/easat-2/software/official/ASK tester/easat2_ask.h

/*
 *                                                       
 * Project     : EASAT2 ASK                                         
 * File        : easat2_ask.h
 *
 * Description : This file include all the necessary project includes
 * Last update : 07 October 2016                                              
 *                                                                            
*/

#ifndef EASAT2_ASK_H
#define	EASAT2_ASK_H

#include <xc.h>
#include "easat2_ask_config.h"
#include "easat2_ask_pinouts.h"

extern volatile int global_timer_flag;      // set to 1 when timer has been fired

#endif
