AMSAT-EA/easat-2/(commit log)

2016-08-26 Added KiCAD project
    [easat2.kicad_pcb, easat2.sch]
2016-08-26 First draft of the MPPT and power circuit
    [MPPT.sch]
2016-08-27 Added ZXCT1009 current monitors
    [MPPT.sch, easat2.sch]
2016-09-06 Corrected current shunt name: ZXCT1009
    [MPPT.sch]
2016-09-07 Documentos iniciales del proyecto
    Documentos sobre estudios de energía, potencia, y propuesta inicial del
    satélite.
2016-09-08 Añadida plantilla para documentos
2016-09-09 Added voltage regulator TC1262
2016-09-17 Updated MPPT
    5 converter blocks, footprints and Digikey references for many components.
    [MPPT.sch, easat2.sch]
2016-09-17 Added SMini2 footprint
    [MPPT.sch]
2016-09-18 First version of MPPT PCB
    [easat2.kicad_pcb]
2016-09-19 Added "AMSAT-EA" to the MPPT PCB silkscreen
    [easat2.kicad_pcb]
2016-09-21 Added DRA818U PinOut and configuration with Arduino
2016-10-01 Borrador 2 de la especificación de requisitos hardware MCU
    Borrador 2 de la especificación de requisitos hardware de la placa del
    MCU
2016-10-01 Especificación de requisitos del subsistema MPPT
    Especificación de requisitos del subsistema MPPT
2016-10-03 Ficheros de includes del configuración del PIC y librería retardos
    Se incluyen los ficheros que configuran los flags del PIC, el mapeo de
    la memoria EEPROM con la tabla MORSE y un mensaje para pruebas, así como
    la librería de retardos.
2016-10-27 First C version to test beacon hardware in development
    This is the first version to test the beacon hardware (see the LED
    light, and the buzzer sound at 1 Khz).
    [EASAT2-MCU-C.X.production.obj]
2016-10-31 Working beacon stable code
    First working stable beacon code. 32 WPM, 3 mins wait
    [EASAT2-MCU-C.X.production.obj]
2016-11-08 MCU project created
    [MCU.kicad_pcb, MCU.sch]
2016-11-12 PIC18F45K22 symbol created. MCU schematic: MCU, resonator
    [MCU.sch]
2016-11-12 MCU: Connectors, watchdog, buzzer added
    [MCU.sch]
2016-11-15 LTSpice simulation for 1KHZ Low Pass Filter. Need to adjust with commercial values for passive components
    [MCU.sch]
2016-12-02 New stable version including Thermometer and ADCs working
    New stable version including Thermometer and ADCs working
    [EASAT2-MCU-C.X.production.obj]
2017-01-02 MCU schematic: Low Pass Filter for BEA signal. DRC cheched and Netlist generated
    [MCU.sch]
2017-01-12 Some footprints added to MCU components
    [MCU.sch]
2017-01-14 All footprints added. Need to check them before manufacturing. Placement started
    [MCU.kicad_pcb, MCU.sch, _saved_MCU.sch]
2017-01-15 MCU board outline defined. Mechanical holes added. Routing started
    [MCU.kicad_pcb, MCU.sch, _saved_MCU.sch]
2017-01-22 Add files via upload
    Versión para actualizar
2017-01-28 High priority interruptions working. Added AGC, energy and command skeleton functions
    Highr priority interruption used for battery consumption, AGC control
    and command configured. Added blinking LED for debugging in RD4. AGC and
    command skeleton functions added
    [EASAT2-MCU-C.X.production.obj]
2017-02-20 PIC schematic of 64 pins. Reorganized pinout
    [MCU.kicad_pcb, MCU.sch]
2017-03-05 Actualizado documento de requisitos del MCU. Incorporado ICD del microcontrolador, interfaz con el modulo de RF y aclaradas algunas conexiones
2017-03-06 Doc about how to charge Lithium-Ion batteries
2017-03-08 Añadido documento de requisitos HW de la MCU en formato PDF
2017-03-08 Corregidas erratas en el documento de requisitos de la MCU. Añadido regulador al esquematico y ajustadas las conexiones acorde a los requisitos
    [MCU.sch]
2017-03-10 Eduardo files about antenna, structure and transponder
    Eduardo files about antenna, structure and transponder
    [16602E03-BUDGET.ods, 16604E01-estructura-y-lanzador.dxf, 16604E02-0estructura3d.dxf, 16604E02-ALA SOLAR DESPLEGABLE.DXF, 16604E02-BASE 50X50.DXF, 16604E02-BASE 56X56.DXF, 16604E02-LATERAL FRONTAL.DXF, 16604E02-LATERAL LATERAL.DXF]
2017-03-10 Especificadas conexiones de las señales DIS y ENA. Actualizado esquematico de la MCU: Actualizadas conexiones, añadido regulador y amplificador
    [MCU.sch]
2017-03-14 Añadida libreria del amplificador operacional LT6005. Añadido a los esquematicos.
    [MCU.kicad_pcb, MCU.sch]
2017-03-15 Audio squelch circuit to ADC for initial testing
    Audio squelch circuit to ADC for initial testing (Eduardo)
2017-03-20 Squelch level detector (first version) working
    Squelch level detector (first version) working. For transmitter to be
    active the input signal must be the double of noise level and be present
    during at least 2 seconds. Transmitter will be active for 2 minutes. It
    is automatically renewed if input signal still meets activation
    conditions.
    ADC reference level set to 2.048 instead of 1.024V.
    [EASAT2-MCU-C.X.production.obj]
2017-03-23 Puestas todas las huellas. Primera colocacion de los componentes hecha. A la espera de la revision de los esquematicos para rutar
    [MCU.kicad_pcb, MCU.sch]
2017-04-01 Pinout configuration centraliced in one file
    Pinout configuration centraliced in one file
    [EASAT2-MCU-C.X.production.obj]
2017-04-01 Updated pinout configuration file and splitted MCU initialize function
    Updated pinout configuration file and splitted MCU initialize function
    [EASAT2-MCU-C.X.production.obj]
2017-04-01 Updated pinout file, ports configuration and definitions
    Updated pinout file, ports configuration and definitions
    [EASAT2-MCU-C.X.production.obj]
2017-04-03 Añadidas señales PTT, RPT, HIPWR, BEACON_MODE. Añadido un conector
    [MCU.kicad_pcb, MCU.sch]
2017-04-08 Weak pull-up port resistors explicit disable, PWM initial files, errata fixed in pinouts
    Weak pull-up port resistors explicit disable, PWM initial files, errata
    fixed in pinouts
    [EASAT2-MCU-C.X.production.obj]
2017-04-12 PWM beacon working. Added signal to hardware watchdog
    PWM beacon working. Added signal to hardware watchdog. Also some code
    reorganization.
    [EASAT2-MCU-C.X.production.obj]
2017-04-26 Requisitos de financiación del proyecto completo
    Se adjunta una versión borrador de los requisitos de financiación del proyecto completo.
2017-04-29 Modificaciones para fabricación: - Añadidos campos en los componentes (esquemáticos). - Añadida carpeta Documentos/Montador/ - Creada primera versión del BOM (formato HTML, CSV y XML).
    [MCU.csv, MCU.kicad_pcb, MCU.sch]
2017-05-07 Squelch level detector - fast version
    Squelch level detector - fast version. Also minor typos in files
    [EASAT2-MCU-C.X.production.obj]
2017-05-15 Placa MCU rutada. Falta: - Mejorar la colocación de algunas pistas - Comprobar las reglas para fabricación - Generar los ficheros de fabricación
    [MCU.kicad_pcb]
2017-05-15 MCU: Añadidos ficheros de fabricacion. Lista para fabricar la versión 1.0 a falta de retoques de serigrafía (logo)
    [MCU.kicad_pcb, MCU.sch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]
2017-05-23 Initial ASK Manchester IEEE 802.3 tester
    ASK Manchester IEEE 802.3 tester (to plug in RF_IN input in IHU board)
    [EASAT2-ASK-TESTER.X.production.obj]
2017-05-28 ASK tester - parameters - added debugging LED
    ASK tester - parameters - added debugging LED
    [EASAT2-ASK-TESTER.X.production.obj]
2017-06-01 ASK decoder first version - untested
    ASK decoder main code, first version - untested
    [EASAT2-MCU-C.X.production.obj]
2017-06-03 MCU Version 1.0 lista para fabricación. Ficheros generados.
    [MCU-B.Adhes.gbr, MCU-B.CrtYd.gbr, MCU-B.Cu.gbr, MCU-B.Fab.gbr, MCU-B.Mask.gbr, MCU-B.Paste.gbr, MCU-Edge.Cuts.gbr, MCU-F.Adhes.gbr]
2017-06-05 - Esquematicos generados - Archivos de fabricacion - BOM para Farnell
    [MCU - farnell.csv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]
2017-06-12 ASK related datasheets and docs
    ASK related datasheets and docs
    [an5426-baseband-calculator.xls]
2017-06-14 Squelch level detector fix
    Squelch level detector fix
    [EASAT2-MCU-C.X.production.obj]
2017-06-14 ASK command decode initial implementation
    ASK command decode initial implementation
    [EASAT2-MCU-C.X.production.obj]
2017-08-29 Moving MPPT files to a proper folder
    Moving MPPT files to a proper folder
    [MPPT.sch, easat2.kicad_pcb, easat2.sch]
2017-09-05 Corregidos errores en el esquematico de la MCU: - Se incorpora el pin MCLR al conector de programacion (P2) y se ordenan acorde al pinout del programador PicKit 3 - La alimentación del microcontrolad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
    [EASAT2-MCU-C.X.production.obj, MCU - farnell.csv, MCU.sch]
2017-10-01 ASK tester working (50 bits / second) 32 bits
    ASK tester working (50 bits / second) 32 bits
    [EASAT2-ASK-TESTER.X.production.obj]
2017-10-01 MCU receiving ASK Manchester command (unclean version)
    MCU receiving ASK Manchester command (unclean version)
    [EASAT2-MCU-C.X.production.obj]
2017-10-19 Presentación EASAT2 IberRadio 2017 Ávila
    Presentación EASAT2 IberRadio 2017 Ávila por Félix Páez EA4GQS - Eduardo Alonso EA3GHS en nombre del equipo de EASAT2
2017-11-01 Reorganized schematics: different sections separated and clarified.
    [MCU.sch]
2017-11-04 Added 3D models of header connectors
    [MCU.kicad_pcb, MCU.sch, User Library-RM254_5pin.STEP]
2017-12-29 Schottky Barrier Diode DB2130200L datasheet
    Schottky Barrier Diode DB2130200L datasheet upload used in MPPT
2017-12-29 Microchip Battery charger MCP73841
    Microchip Battery charger MCP73841 IC
2018-01-03 Varta Battery and Dual comparator Sheets
    Varta Battery and Dual comparator Sheets (used in Swiss Cube)
2018-01-06 Evolution of MPPT design
    Evolution of MPPT design. Added additional safe diodes, some parts
    reorganized. Numeration of resistors, capacitors and diodes made more
    clear.
    [MPPT.sch, easat2.kicad_pcb, easat2.sch]
2018-01-06 MPPT Evolution - generated new PDF schematic file
    MPPT Evolution - generated new PDF schematic file
    [MPPT.sch]
2018-01-07 Added out pins from panels to MCU
    Added out pins from panels to MCU so voltage of each one can be measured
    by CPU
    [MPPT.sch]
2018-01-07 Generated new MPPT PDF schematic
    Generated new MPPT PDF schematic
2018-02-13 Microchip MIC2045 MOSFET switches
    Microchip MIC2045 MOSFET switches for battery connect / disconnect protection
2018-02-21 Latch up protection techniques and parts
    Latch-Up Protection For MOSFET Drivers
    BU-CA Series - TBU ® High-Speed Protectors
2018-03-03 Placement terminado para la versión 2.0 de la MCU
    [MCU.kicad_pcb, MCU.sch]
2018-03-12 Add files via upload
    ojales en MLI o remaches metálicos.. (idea para mecanizado)
2018-03-19 Sensolute Micro Vibration Sensor datasheets
    Sensolute Micro Vibration Sensor datasheets
2018-04-02 MPPT evolution added missing models, replaced componentes
    MPPT evolution added missing models, replaced componentes, routed again.
    [MPPT.sch, easat2.dsn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]
2018-04-06 Added Radiation Sensor BG51 datasheet
    Added Radiation Sensor BG51 datasheet
2018-04-07 MPPT board big version for electrical testing
    MPPT board big version for electrical testing
    [MPPT.sch, easat2.dsn, easat2.kicad_pcb, easat2.sch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]
2018-04-07 MPPT board - Added holes, size set to 42mm, full routed
    MPPT board - Added holes, size set to 42mm, full routed
    [easat2.dsn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]
2018-04-11 Added ground planes to MPPT evolution
    Added ground planes to MPPT evolution. Deleted big PCB version
    [MPPT.sch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]
2018-04-16 MIKROE-2806 LTC3129 prototype board datasheet
    MIKROE-2806 LTC3129 prototype board datasheet
2018-04-29 LTC3129-1 fixed voltage LTC3129 version datasheet
    LTC3129-1 fixed voltage LTC3129 version datasheet
2018-05-03 LP2951N / RT9728A
    LP2951N voltage regulator and RT9728A Power Switch with Programmable Current Limit Datasheets
2018-05-18 EPS with battery management update
    EPS with battery management update
    [MPPT.sch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]
2018-05-18 IHU datasheet
    IHU datasheet
    [MCU - farnell.csv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]
2018-05-21 SPV1040 - High efficiency solar battery charger
    SPV1040 - High efficiency solar battery charger
2018-05-21 EPS clean version
    EPS clean version
    [EPS.kicad_pcb, EPS.sch, MPPT.sch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]
2018-05-24 Reglas de diseño EDR para EPS
2018-05-28 PCB EPS
    versión 0
    [EPS.kicad_pcb, EPS.sch]
2018-05-30 Actualización PCB EPS
    [EPS.kicad_pcb]
2018-06-21 Uploaded 1N4001 and 1N5819 diodes datasheets
    Uploaded 1N4001 and 1N5819 diodes datasheets
2018-09-05 PWM battery charger example
    PWM battery charger example
